havardh/bitless/README.md

TDT4295
=======

Datamaskinprosjektet 2013 - Energigruppa

NEWS:
* EBI is working!
* The SDcard is working!!!
* We have sound!
* Working on report structure! Using this: http://www.idi.ntnu.no/emner/tdt4260/_media/arch-paper-howto-2013.pdf
