havardh/bitless/docs/README.md

Documents
=========

A list of links to external documents used throughout the design process.

Xilinx Documents
----------------

* <a href="http://www.xilinx.com/support/documentation/sw_manuals/xilinx12_4/spartan6_hdl.pdf">Spartan-6 Libraries Guide for HDL Designs</a>
* <a href="http://www.xilinx.com/support/documentation/user_guides/ug382.pdf">Spartan-6 FPGA Clocking Resources</a>
* <a href="http://www.xilinx.com/support/documentation/user_guides/ug389.pdf">Spartan-6 FPGA DSP48A1 Slice</a>

ARM Documents
-------------

* <a href="http://infocenter.arm.com/help/topic/com.arm.doc.ddi0403c/index.html">ARMv7-M ARM Architecture Reference Manual</a> (for Cortex-M3 and -M4)
* <a href="http://infocenter.arm.com/help/index.jsp?topic=/com.arm.doc.ddi0419c/index.html">ARMv6-M ARM Architecture Reference Manual</a> (for Cortex-M0 and -M1)
* <a href="http://infocenter.arm.com/help/topic/com.arm.doc.set.cortexm/index.html">ARM Cortex-M Series Processor Documentation</a>

Energy Micro Documents
----------------------

* <a href="http://cdn.energymicro.com/dl/an/pdf/an0034_efm32_ebi.pdf">EFM32 External Bus Interface</a>
* <a href="http://cdn.energymicro.com/dl/an/pdf/an0030_efm32_fat_on_sd_card.pdf">EFM32 Fat on SD Card</a>
* <a href="http://cdn.energymicro.com/dl/an/pdf/an0002_efm32_hardware_design_considerations.pdf">EFM32 Hardware Design Considerations</a>
* <a href="http://cdn.energymicro.com/dl/devices/pdf/d0053_efm32gg_reference_manual.pdf">EFM32GG Reference Manual</a>

Various components
------------------
* <a href="http://www.farnell.com/datasheets/1647396.pdf">FT232RL - USB-USART Bridge</a>
