havardh/bitless/report/title.tex

% !TEX root = ./report.tex
\begin{titlepage}

\begin{center}

{\huge Bitless}\\[0.5cm]

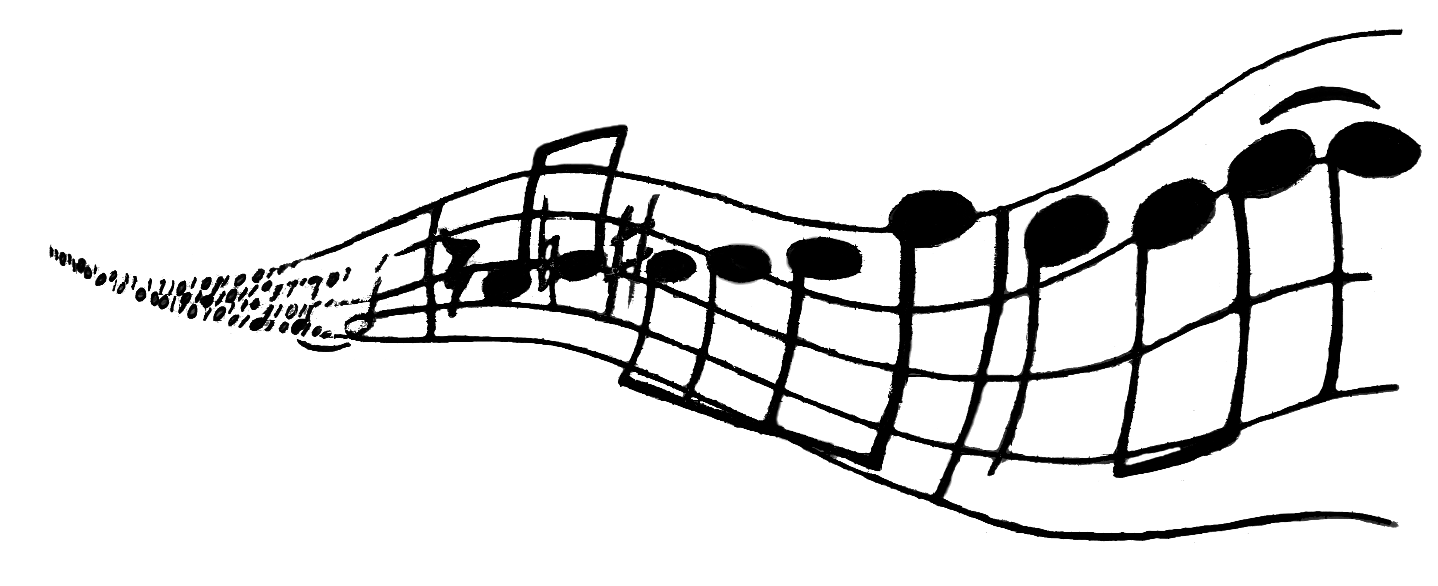
[picture p1: report/figures/logo.png]
    \\[2.5cm]

\textsc{\LARGE TDT4295 - computer design project}\\[2cm]

%\hrule{\linewidth}{0.35mm} %doesn't work

\begin{table}[h]
\centering
\begin{tabular}{rl}
    \textsc{Kristian Klomsten Skordal}  & \textsc{Jakob Dagsland Knutsen} \\
    \textsc{Hanna Holler Kamperud}      & \textsc{Håvard Wormdal Høiby} \\
    \textsc{Runar Bergheim Olsen}       & \textsc{Magnus Halvorsen}	\\
    \textsc{Olav Emil Eiksund}          & \textsc{Christian Chavez} \\
    \textsc{Sondre Lefsaker}            & \textsc{Terje Runde}
\end{tabular}
\end{table}

\vfill
\large{\today}

\end{center}

\end{titlepage}
