havardh/bitless/report/chapters/appendices.tex

% !TEX root = ../report.tex

\appendix
\begin{appendix}

\input{chapters/appendices/full-isa}
\input{chapters/appendices/fourier-transform}
\input{chapters/appendices/schematics}

\end{appendix}
