havardh/bitless/report/chapters/implementation.tex

% !TEX root = ../report.tex

\chapter{Implementation}\label{chapter:implementation}

This chapter describes implementation details of the system, and discusses decisions from the design process. It gives an overview of the \textit{ChaosM} implementation on the FPGA, how the MCU handles I/O and dataflow, and the PCB design. \clearpage

\clearpage
\input{chapters/implementation/system_overview}
\clearpage
\input{chapters/implementation/theory}
\clearpage
\input{chapters/implementation/fpga}
\clearpage
\input{chapters/implementation/mcu}
\clearpage
\input{chapters/implementation/pcb}
