havardh/bitless/report/chapters/methodology.tex

% !TEX root = ../report.tex

\chapter{Testing}\label{chapter:methodology}

This chapter details all the testing and their methodologies, as well as any
fixes implemented on the system.

\clearpage
\input{chapters/methodology/fpga-simulation}
\clearpage
\input{chapters/methodology/mcu-testing}
\clearpage
\input{chapters/methodology/pcb-testing}

% unit tests (cpputest)
% test programs (demos)
