havardh/bitless/report/figures/sw/fpga.tex

\begin{figure}[H]
    \centering
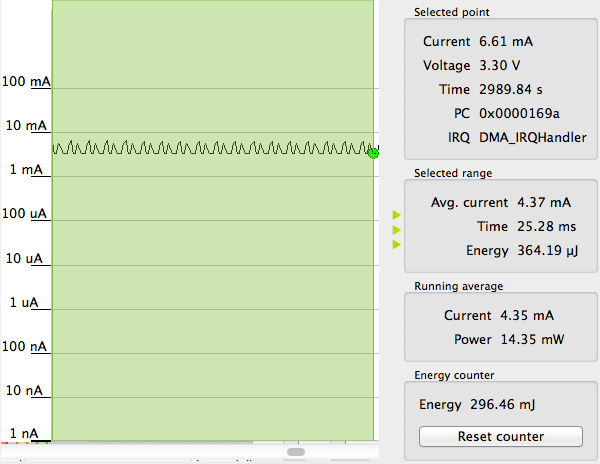
[picture p2: report/figures/sw/fpga.png]
    
    \caption{The energy usage during DMA}
    \label{fig:fpga}
\end{figure}
