havardh/bitless/report/chapters/appendices/fpga-core.tex

\begin{figure}[H]
	\centering
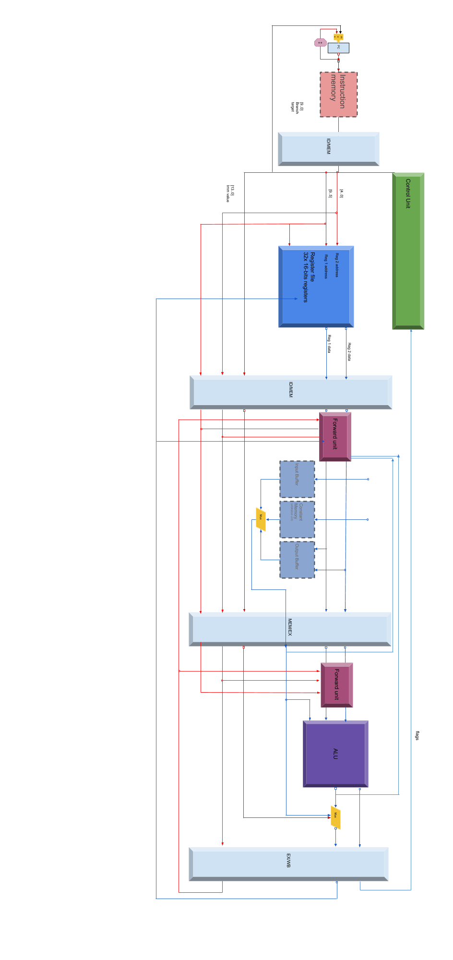
[picture p3: report/figures/fpga/core_schematic.png]
	
	\caption{A simplified schematic of the processor core design.}
	\label{fig:core_schematic}
\end{figure}
