havardh/bitless/report/chapters/appendices/schematics.tex

% !TEX root = ../../report.tex

\chapter{Schematics}\label{apx:schematics}

\section{ChaosM Schematics}
\clearpage
\input{chapters/appendices/fpga-core}

\section{PCB Schematics}
\includepdf[pages=-]{../pcb/take1/take1.pdf}
