havardh/bitless/report/figures/sw/sample-flow.tex

% !TEX root = ../../report.tex

\begin{figure}[H]
	\centering
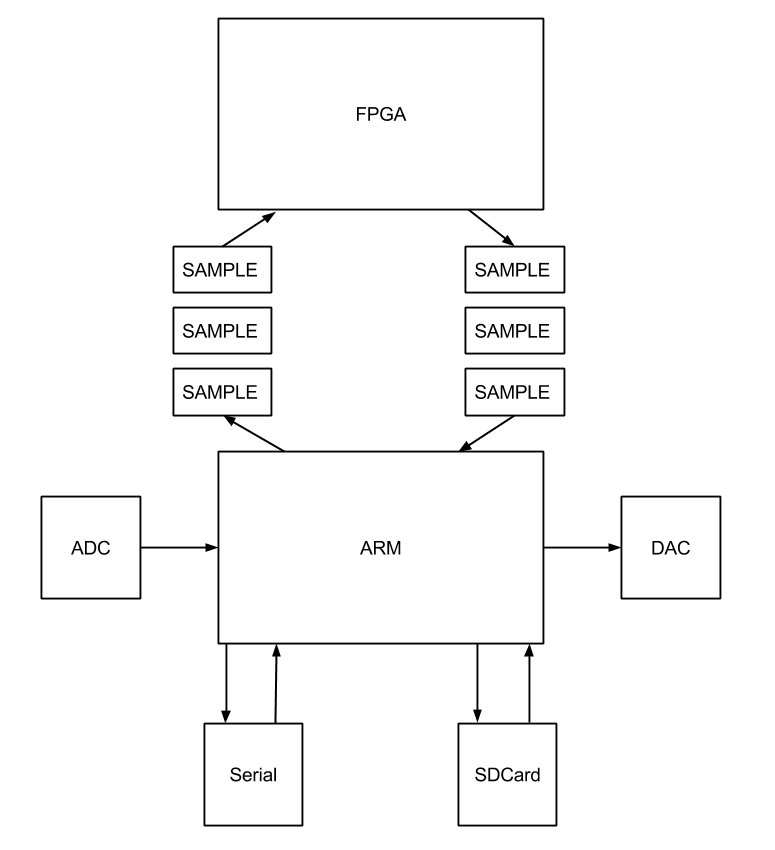
[picture p6: report/figures/sw/sample-flow.png]
	
	%\begin{tikzpicture}[shorten >= 1pt, node distance=3cm, on grid, auto]
	%	\node[draw,rectangle,minimum size=2cm] (fpga) {FPGA};
	%	\node[draw,rectangle,below of=fpga,minimum size=2cm] (arm) {ARM};
	%\end{tikzpicture}
	\caption{Flow of samples}
	\label{fig:sw_sample_flow}
\end{figure}
