havardh/bitless/report/figures/fpga/communication-ebi-addresses.tex

\begin{figure}[H]
	\centering
	\begin{bytefield}[endianness=big,bitwidth=0.04\linewidth]{23}
		\bitheader{0-22}\\
		\bitbox{1}{T} &
		\bitbox{2}{\tiny Pipeline} &
		\bitbox{4}{Device} &
		\bitbox{2}{\tiny Subdev} &
		\bitbox{14}{Address}
	\end{bytefield}
	\caption{FPGA address format}
	\label{fig:ebi_addresses}
\end{figure}
