havardh/bitless/report/figures/intro/pcb/bitless_overview.tex

\begin{figure}[H]
    \centering
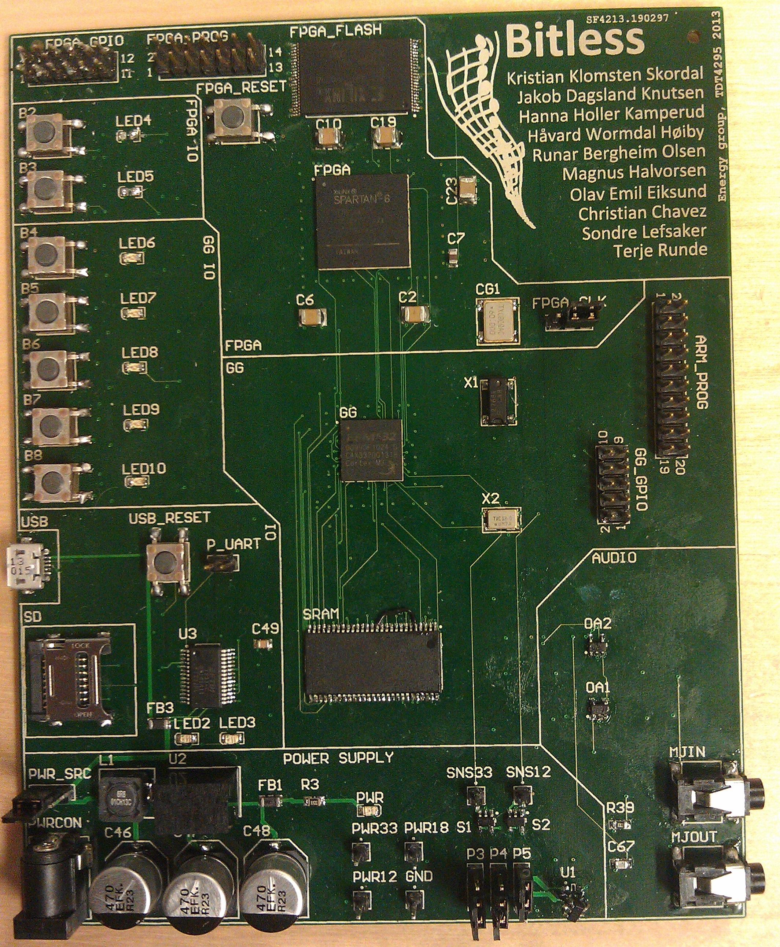
[picture p10: report/figures/intro/pcb/bitless_overview.jpg]
    
    \caption{The Bitless computer}
    \label{fig:bitless_overview}
\end{figure}
