havardh/bitless/report/figures/intro/pcb/bitless_psu.tex

\begin{figure}[H]
    \centering
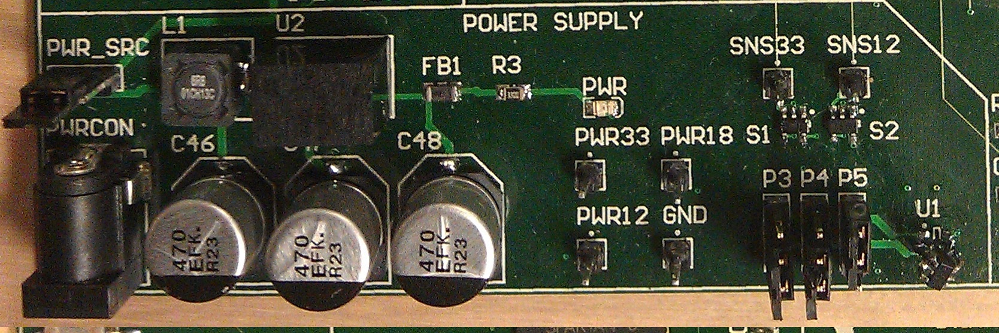
[picture p11: report/figures/intro/pcb/bitless_psu.jpg]
    
    \caption{The power supply}
    \label{fig:psu}
\end{figure}
