havardh/bitless/report/chapters/implementation/pcb/layout.tex

\subsection{Layout}

Drawing connections between components on a PCB can be a complicated process,
and is crucial to a successful PCB design. Following is how the PCB layout
of this project's system was implemented.

\input{chapters/implementation/pcb/layout/routing}
\input{chapters/implementation/pcb/layout/layer_stack}
\input{chapters/implementation/pcb/layout/footprints}
