havardh/bitless/report/chapters/implementation/pcb/ee_design.tex

% !TEX root = ../../../report.tex

\subsection{Designing for energy efficiency}

The PCB
