havardh/bitless/report/chapters/implementation/mcu/modes.tex

\subsection{Modes}

As described in the introduction the system has multiple input and output
sources for the samples flowing through the system. The modes consists of the
different combinations of sources and are as follows:

\begin{enumerate}
\item ADC to DAC - Like an effect pedal
\item ADC to SDCard - Like a taperecorder
\item SDCard to DAC - Like a wavplayer
\item SDCard to SDCard - Like a
	%\caption{Dataflow modes}
	\label{enum:data_flow_modes}
\end{enumerate}
