havardh/bitless/report/chapters/implementation/pcb/layout/footprints.tex

% !TEX root = ../../../../report.tex
\subsubsection{Footprints}

Each component is associated with a schematic drawing and a footprint. Because certain components were not available in public libraries they had to be drawn from scratch. Below is a list of all custom component drawings.

\begin{table}[H]
	\centering
	\begin{tabular}{| l | c | c |}
		\hline
		\textbf{Component} & \textbf{Footprint}  & \textbf{Schematic} \\
		\hline
		XP Power Switch-Mode Regulator & X & X \\
		Würth Electronics MicroSD & X & X \\
		Molex MicroUSB AB & X & X \\
		Lumberg 3.5mm audio jack & X & X \\
		Buttons & X & X \\
		DC-10B & X & X \\
		\hline
		Texas Instruments Op amp & - & X \\
		Diodes INC. Linear regulator& - & X \\
		Diodes INC. Current Monitor & - & X \\
		Cypress Semiconductor SRAM & - & X \\
		TXC-7B crystal & - & X \\
		TXC-7W crystal & - & X \\
		\hline
	\end{tabular}
	\caption{Custom footprints and schematics}
	\label{tab:footprints}
\end{table}
