havardh/bitless/report/chapters/implementation/pcb/layout/routing.tex

% !TEX root = ../../../../report.tex

\subsubsection{Routing}

Almost everything was autorouted, with a few exceptions. The power supply had to be done manually, as well as the fanout on the FPGA. The routes are visible in the last image of Appendix~\ref{apx:schematics}.
