havardh/bitless/report/acks.tex

\section*{Acknowledgments}
We would like to thank the following people for their help and input during the
project:

\begin{description}
  \item[Gunnar Tufte] for coordinating the project, and being himself
  \item[Yaman Umuroglu] for always being available for questions
  \item[Odd Rune S. Lykkebø] for providing technical support on every level
  \item[Stefano Nichele] for helping out with our orders
  \item[Stian Hvatum] for excellent support during PCB development
  \item[Team Barricelli] for timesharing the labs
\end{description}
\newpage
