havardh/bitless/report/report.tex

\documentclass[fontsize=11pt,paper=a4,titlepage,openany]{report}

\input{config} % Insert style

\begin{document}

\input{./title}
\input{./acks}
\input{./abstract}

\tableofcontents
\newpage
\listoffigures
\listoftables
%\lstlistoflistings

\input{chapters/intro}
\input{chapters/implementation}
\input{chapters/methodology}
\input{chapters/results}
\input{chapters/conclusion}

\bibliography{bibliography}{}
\bibliographystyle{plain}

\input{chapters/appendices}

\end{document}
