havardh/bitless/report/figures/sw/preamp.tex

\begin{figure}[H]
    \centering
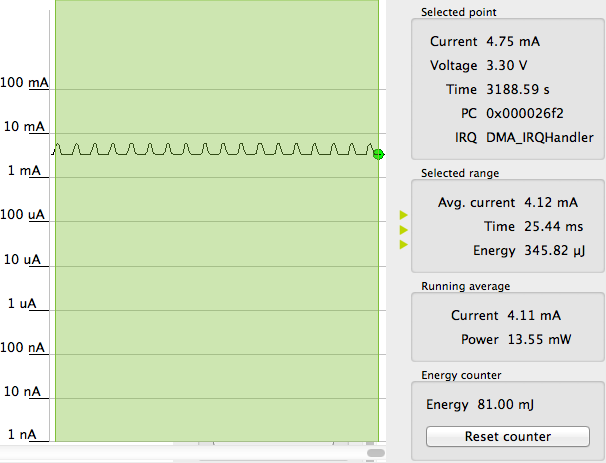
[picture p12: report/figures/sw/preamp.png]
    
    \caption{Energy usage for demo code}
    \label{fig:preamp}
\end{figure}
