havardh/bitless/report/figures/sw/software-stack.tex

\begin{figure}[H]
    \centering
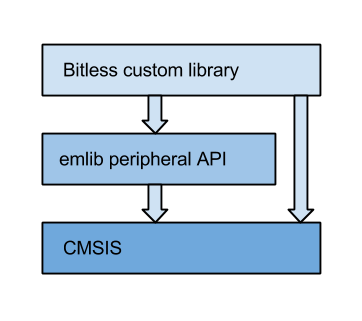
[picture p15: report/figures/sw/software-stack.png]
    
    \caption{The software stack used on the microcontroller}
    \label{fig:software-stack}
\end{figure}
