havardh/bitless/report/figures/sw/transfer-phases.tex

\begin{figure}[H]
	\centerline{
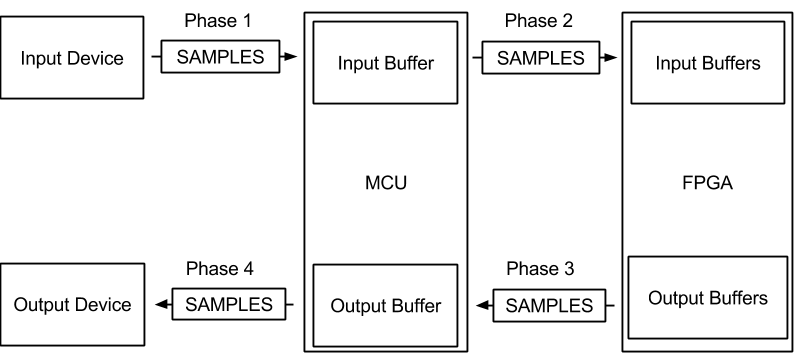
[picture p16: report/figures/sw/transfer-phases.png]
	}
	\caption{Transfer phases}
	\label{fig:sw_transfer_phases}
\end{figure}
\FloatBarrier
