havardh/bitless/report/figures/intro/nonfunctional-reqs.tex

\begin{table}[H]
\centering
    \begin{tabular}{| l | p{8cm} |}
    \hline
    \textbf{Name} & \textbf{Requirement}\\
    \hline \hline
    \textbf{NFR1} & The project should have a cool name and logo. \\
    \textbf{NFR4} & The FPGA must be a Xilinx Spartan 6 \\
    \textbf{NFR5} & The microcontroller should be an EFM32GG990F1024 \\
    \textbf{NFR6} & The final system should be optimized for low energy consumption \\
    \textbf{NFR7} & The budget of 10.000 NOK should cover all production 
    and component expenses. \\

    \hline
    \end{tabular}
    \caption{The non-functional requirements}
    \label{tab:nonfunref}
\end{table}
