havardh/bitless/report/figures/fpga/communication-ebi-read.tex

\begin{figure}[h]
	\centering
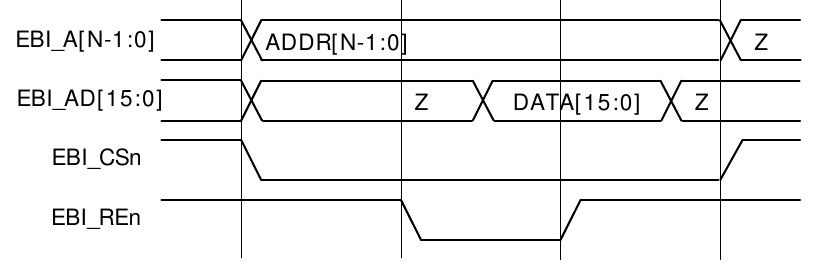
[picture p17: report/figures/fpga/ebi_read.png]
	
	\caption{EBI read transfer\cite[p.7]{efm_ebi}}
	\label{fig:ebi_read}
\end{figure}
