havardh/bitless/report/figures/fpga/communication-ebi-write.tex

\begin{figure}[h]
	\centering
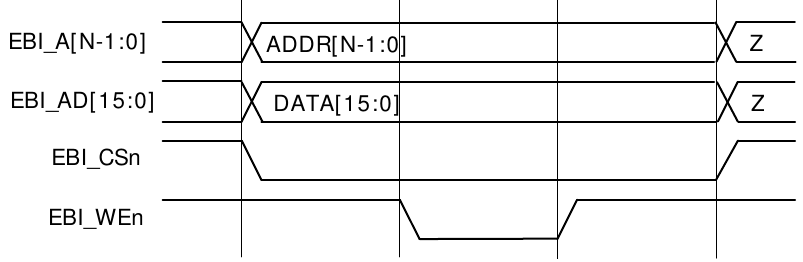
[picture p18: report/figures/fpga/ebi_write.png]
	
	\caption{EBI write transfer\cite[p.6]{efm_ebi}}
	\label{fig:ebi_write}
\end{figure}
