havardh/bitless/report/chapters/pcb/components/usb_uart.tex

% !TEX root = ../../report.tex

\subsection{USB-UART}

{\bf USB-UART}
\begin{itemize} \item FTDI FT232RL - USB-UART converter \item 1x 4k7 and 1x 10k
\item 3x 100nF and 1x 4.7uF \item USB3140-30-0170-1-C USB Micro B connector
\end{itemize}
