havardh/bitless/report/figures/fpga/isa-regbased-instructions.tex

\begin{table}[H]
	\centering
	\begin{tabular}{|l l l l l|}
		\hline
		\textbf{Funct} & \textbf{Opt}  & \textbf{Mnemonic} & \textbf{Instruction} & \textbf{Operation} \\
	\hline
	\multicolumn{5}{|c|}{Group \texttt{0b00}} \\
	\hline
	\multirow{3}{*}{\texttt{0b00}}
		& \texttt{0b00} & \texttt{add \$ra, \$rb}  & Add registers & $\$ra \leftarrow \$ra + \$rb$ \\
		& \texttt{0b01} & \texttt{addi \$ra, imm} & Add immediate & $\$ra \leftarrow \$ra + imm$ \\
		& \texttt{0b10} & \texttt{fadd \$ra, \$rb} & Add registers (FP) & $\$ra \leftarrow \$ra + \$rb$ \\
	\multirow{4}{*}{\texttt{0b01}}
		& \texttt{0b00} & \texttt{sub \$ra, \$rb}  & Subtract registers & $\$ra \leftarrow \$ra - \$rb$ \\
		& \texttt{0b01} & \texttt{fsub \$ra, \$rb} & Subtract registers (FP) & $\$ra \leftarrow \$ra - \$rb$ \\
		& \texttt{0b10} & \texttt{cmp \$ra, \$rb}  & Compare & $cnd \leftarrow cnd(\$ra - \$rb)$ \\
		& \texttt{0b11} & - & compare fp / subtract imm? & - \\
	\multirow{4}{*}{\texttt{0b10}}
		& \texttt{0b00} & \texttt{mul \$ra, \$rb}  & Multiply registers & $\$ra \leftarrow \$ra * \$rb$ \\
		& \texttt{0b01} & \texttt{fmul \$ra, \$rb} & Multiply registers (FP) & $\$ra \leftarrow \$ra * \$rb$ \\
		& \texttt{0b10} & \texttt{fmla \$ra, \$rb} & Multiply-and-accumulate (FP) & $\$ra \leftarrow \$ra + \$rb * \$rc$ \\
		& \texttt{0b11} & \texttt{fmls \$ra, \$rb} & Multiply-and-subtract (FP) & $\$ra \leftarrow \$ra - \$rb * \$rc$ \\
	\multirow{4}{*}{\texttt{0b11}}
		& \texttt{0b0x} & \texttt{halt} & Stop processor &  \\
		& \texttt{0b10} & \texttt{fmla \$ra, \$rb} & Multiply-and-accumulate (FP) & $\$ra \leftarrow \$ra + \$rb * \$rd$ \\
		& \texttt{0b11} & \texttt{fmls \$ra, \$rb} & Multiply-and-subtract (FP) & $\$ra \leftarrow \$ra - \$rb * \$rd$ \\
	\hline
	\multicolumn{5}{|c|}{Group \texttt{0b01}} \\
	\hline
	\multirow{2}{*}{\texttt{0b00}}
		& \texttt{0b00} & \texttt{and \$ra, \$rb} & And & $\$ra \leftarrow \$ra \wedge \$rb$ \\
		& \texttt{0b01} & \texttt{nand \$ra, \$rb} & Nand & $\$ra \leftarrow \neg(\$ra \wedge \$rb)$ \\
	\multirow{3}{*}{\texttt{0b01}}
		& \texttt{0b00} & \texttt{or \$ra, \$rb} & Or & $\$ra \leftarrow \$ra \vee \$rb$ \\
		& \texttt{0b01} & \texttt{nor \$ra, \$rb} & Nor & $\$ra \leftarrow \neg(\$ra \vee \$rb)$\\
		& \texttt{0b10} & \texttt{xor \$ra, \$rb} & Xor & $\$ra \leftarrow \$ra \oplus \$rb$\\
	\multirow{4}{*}{\texttt{0b10}}
		& \texttt{0b00} & \texttt{mov \$ra, \$rb} & Move & $\$ra \leftarrow \$rb$\\
		& \texttt{0b01} & \texttt{mvn \$ra, \$rb} & Move negative & $\$ra \leftarrow \neg\$rb$ \\
		& \texttt{0b10} & \texttt{i2f \$ra, \$rb} & Typecast (Int to FP) & $\$ra \leftarrow fp(\$rb)$ \\
		& \texttt{0b11} & \texttt{f2i \$ra, \$rb} & Typecast (Fp to int) & $\$ra \leftarrow int(\$rb)$ \\
	\multirow{4}{*}{\texttt{0b11}}
		& \texttt{0b00} & \texttt{lda \$ra, [\$rb]} & Load from input & $\$ra \leftarrow [\$rb]$ \\
		& \texttt{0b01} & \texttt{ldb \$ra, [\$rb]} & Load from output & $\$ra \leftarrow [\$rb]$ \\
		& \texttt{0b10} & \texttt{ldc \$ra, [\$rb]} & Load from constant buffer & $\$rd\ and\ \$rc \leftarrow [\$rb]$ \\
		& \texttt{0b11} & \texttt{stb \$ra, [\$rb]} & Store to output & $[\$rb] \leftarrow \$ra$ \\
	\hline
	\end{tabular}
	\caption{Register-based instruction list}
	\label{tab:regbased_instrs}
\end{table}
