havardh/bitless/report/figures/results/pcb/bus.tex

\begin{figure}[H]
    \centering
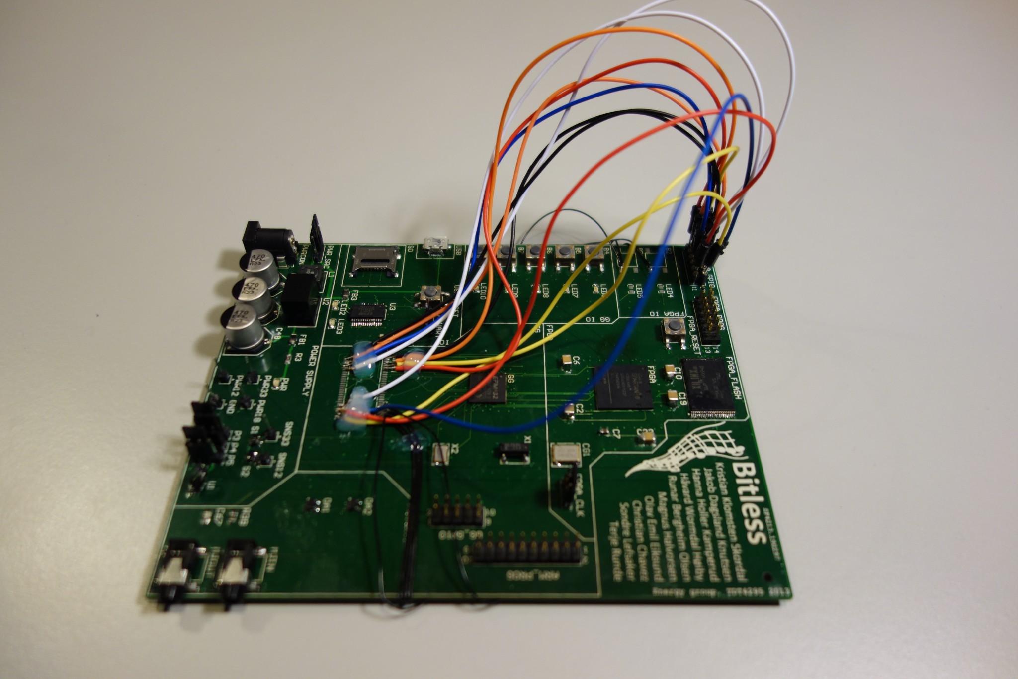
[picture p19: report/figures/results/pcb/bus.jpg]
    
    \caption{Bus hack.}
    \label{fig:res:bus}
\end{figure}
