havardh/bitless/report/figures/results/pcb/lfxtal.tex

\begin{figure}[H]
    \centering
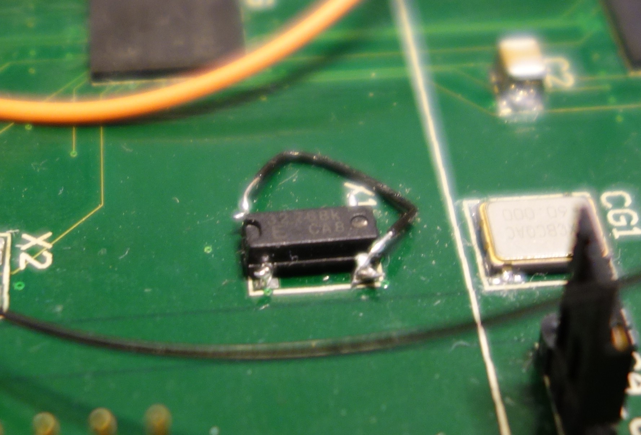
[picture p20: report/figures/results/pcb/lfxtal.jpg]
    
    \caption{Low frequency crystal hack.}
    \label{fig:res:lfxtal}
\end{figure}
