havardh/bitless/report/figures/results/pcb/linear-regulator.tex

\begin{figure}[H]
    \centering
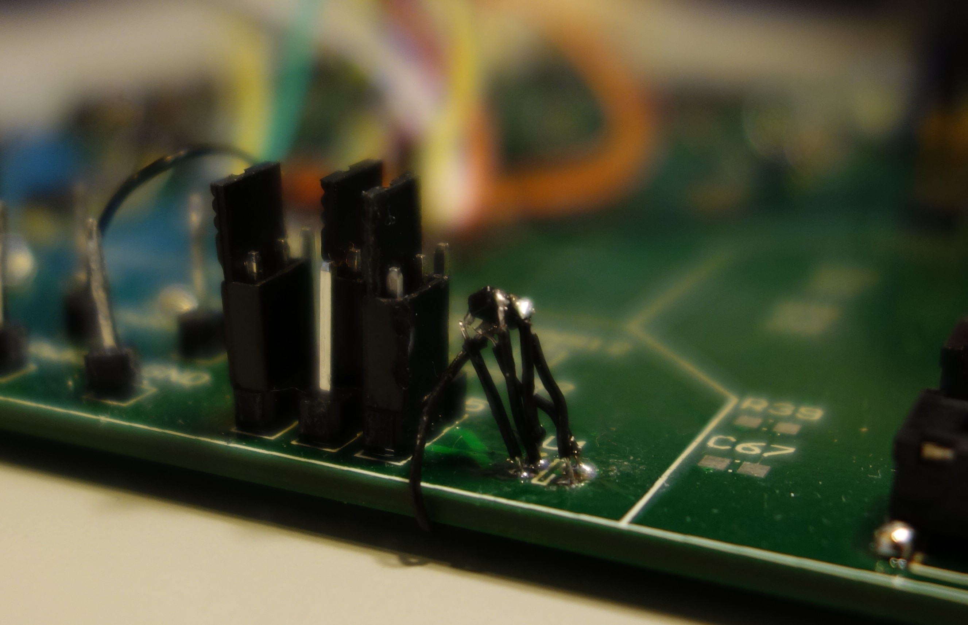
[picture p21: report/figures/results/pcb/linear-regulator.jpg]
    
    \caption{Linear voltage regulator hack.}
    \label{fig:res:linreg}
\end{figure}
