havardh/bitless/vhdl/pipeline/core/alu/generated cores/fix_to_float/fix_to_float_readme.txt

The following files were generated for 'fix_to_float' in directory 
Z:\TDT4295_3\ipcore_dir\

fix_to_float.asy:
   Graphical symbol information file. Used by the ISE tools and some
   third party tools to create a symbol representing the core.

fix_to_float.gise:
   ISE Project Navigator support file. This is a generated file and should
   not be edited directly.

fix_to_float.ngc:
   Binary Xilinx implementation netlist file containing the information
   required to implement the module in a Xilinx (R) FPGA.

fix_to_float.sym:
   Please see the core data sheet.

fix_to_float.v:
   Verilog wrapper file provided to support functional simulation.
   This file contains simulation model customization data that is
   passed to a parameterized simulation model for the core.

fix_to_float.veo:
   VEO template file containing code that can be used as a model for
   instantiating a CORE Generator module in a Verilog design.

fix_to_float.vhd:
   VHDL wrapper file provided to support functional simulation. This
   file contains simulation model customization data that is passed to
   a parameterized simulation model for the core.

fix_to_float.vho:
   VHO template file containing code that can be used as a model for
   instantiating a CORE Generator module in a VHDL design.

fix_to_float.xco:
   CORE Generator input file containing the parameters used to
   regenerate a core.

fix_to_float.xise:
   ISE Project Navigator support file. This is a generated file and should
   not be edited directly.

fix_to_float_readme.txt:
   Text file indicating the files generated and how they are used.

fix_to_float_xmdf.tcl:
   ISE Project Navigator interface file. ISE uses this file to determine
   how the files output by CORE Generator for the core can be integrated
   into your ISE project.

fix_to_float_flist.txt:
   Text file listing all of the output files produced when a customized
   core was generated in the CORE Generator.

Please see the Xilinx CORE Generator online help for further details on
generated files and how to use them.
