havardh/bitless/vhdl/pipeline/core/alu/generated cores/float_to_fix/float_to_fix_readme.txt

The following files were generated for 'float_to_fix' in directory 
Z:\TDT4295_3\ipcore_dir\

float_to_fix.asy:
   Graphical symbol information file. Used by the ISE tools and some
   third party tools to create a symbol representing the core.

float_to_fix.gise:
   ISE Project Navigator support file. This is a generated file and should
   not be edited directly.

float_to_fix.ngc:
   Binary Xilinx implementation netlist file containing the information
   required to implement the module in a Xilinx (R) FPGA.

float_to_fix.sym:
   Please see the core data sheet.

float_to_fix.v:
   Verilog wrapper file provided to support functional simulation.
   This file contains simulation model customization data that is
   passed to a parameterized simulation model for the core.

float_to_fix.veo:
   VEO template file containing code that can be used as a model for
   instantiating a CORE Generator module in a Verilog design.

float_to_fix.vhd:
   VHDL wrapper file provided to support functional simulation. This
   file contains simulation model customization data that is passed to
   a parameterized simulation model for the core.

float_to_fix.vho:
   VHO template file containing code that can be used as a model for
   instantiating a CORE Generator module in a VHDL design.

float_to_fix.xco:
   CORE Generator input file containing the parameters used to
   regenerate a core.

float_to_fix.xise:
   ISE Project Navigator support file. This is a generated file and should
   not be edited directly.

float_to_fix_readme.txt:
   Text file indicating the files generated and how they are used.

float_to_fix_xmdf.tcl:
   ISE Project Navigator interface file. ISE uses this file to determine
   how the files output by CORE Generator for the core can be integrated
   into your ISE project.

float_to_fix_flist.txt:
   Text file listing all of the output files produced when a customized
   core was generated in the CORE Generator.

Please see the Xilinx CORE Generator online help for further details on
generated files and how to use them.
