havardh/bitless/vhdl/pipeline/core/alu/generated cores/fix_to_float/fix_to_float_flist.txt

# Output products list for <fix_to_float>
_xmsgs\pn_parser.xmsgs
fix_to_float.asy
fix_to_float.gise
fix_to_float.ngc
fix_to_float.sym
fix_to_float.v
fix_to_float.veo
fix_to_float.vhd
fix_to_float.vho
fix_to_float.xco
fix_to_float.xise
fix_to_float_flist.txt
fix_to_float_readme.txt
fix_to_float_xmdf.tcl
