havardh/bitless/vhdl/pipeline/core/alu/generated cores/float_to_fix/float_to_fix_flist.txt

# Output products list for <float_to_fix>
_xmsgs\pn_parser.xmsgs
float_to_fix.asy
float_to_fix.gise
float_to_fix.ngc
float_to_fix.sym
float_to_fix.v
float_to_fix.veo
float_to_fix.vhd
float_to_fix.vho
float_to_fix.xco
float_to_fix.xise
float_to_fix_flist.txt
float_to_fix_readme.txt
float_to_fix_xmdf.tcl
