havardh/bitless/pcb/efm32_pinout/pinout.pdf

## EFM32GG990F1024, package BGA112 - Top view

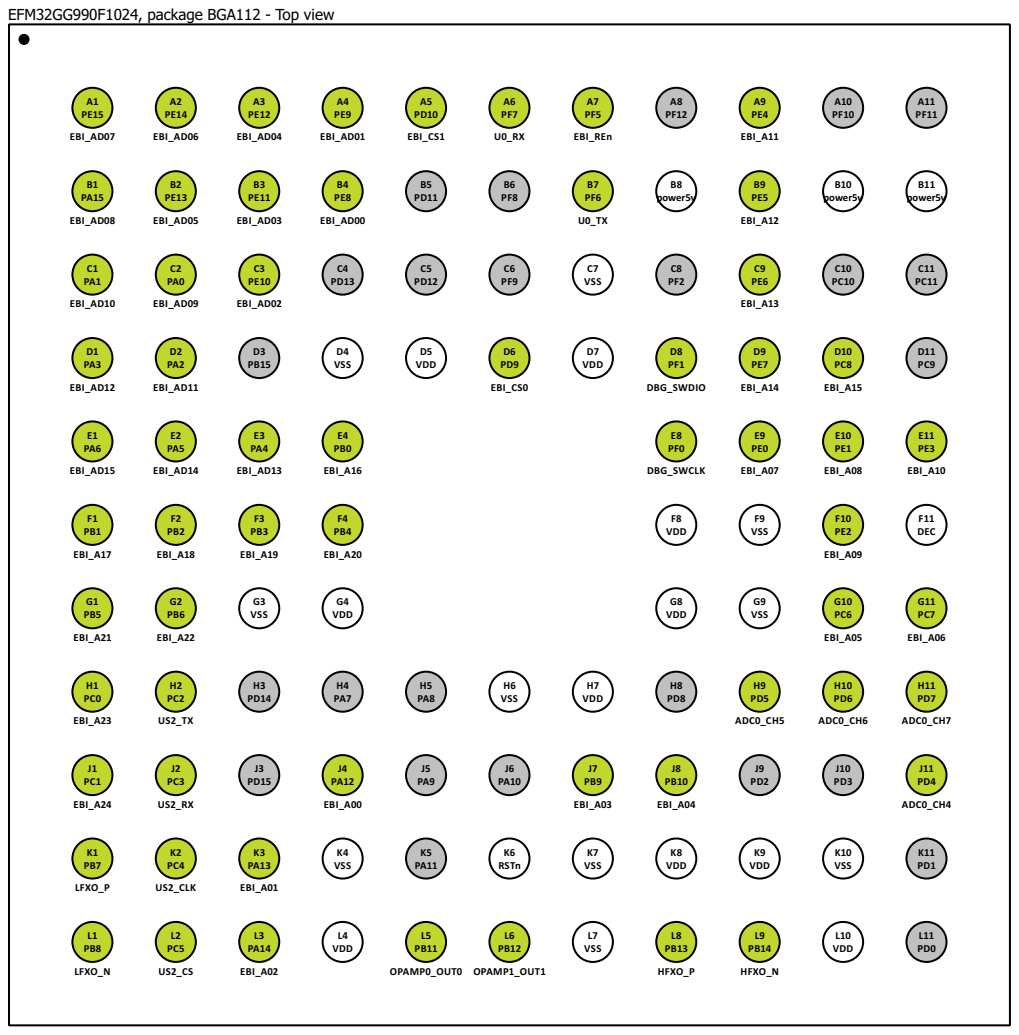
[picture p22: page 1]
