havardh/bitless/pcb/take1/take1.pdf

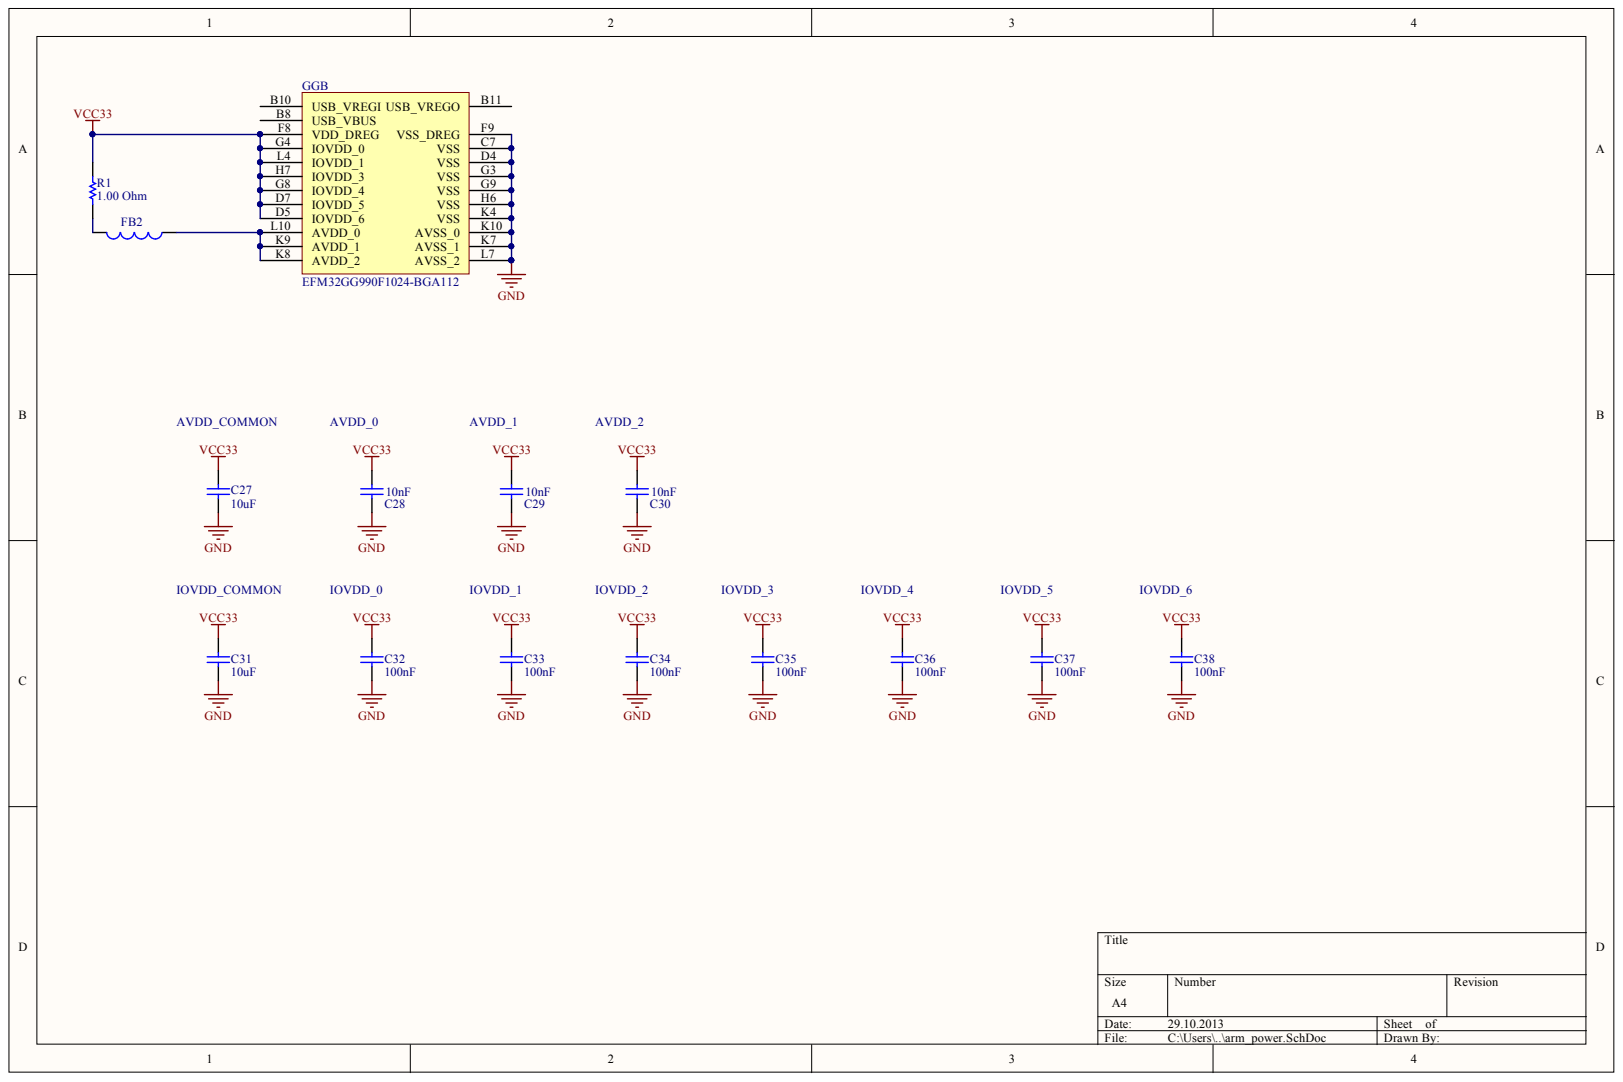
[picture p23: page 1]

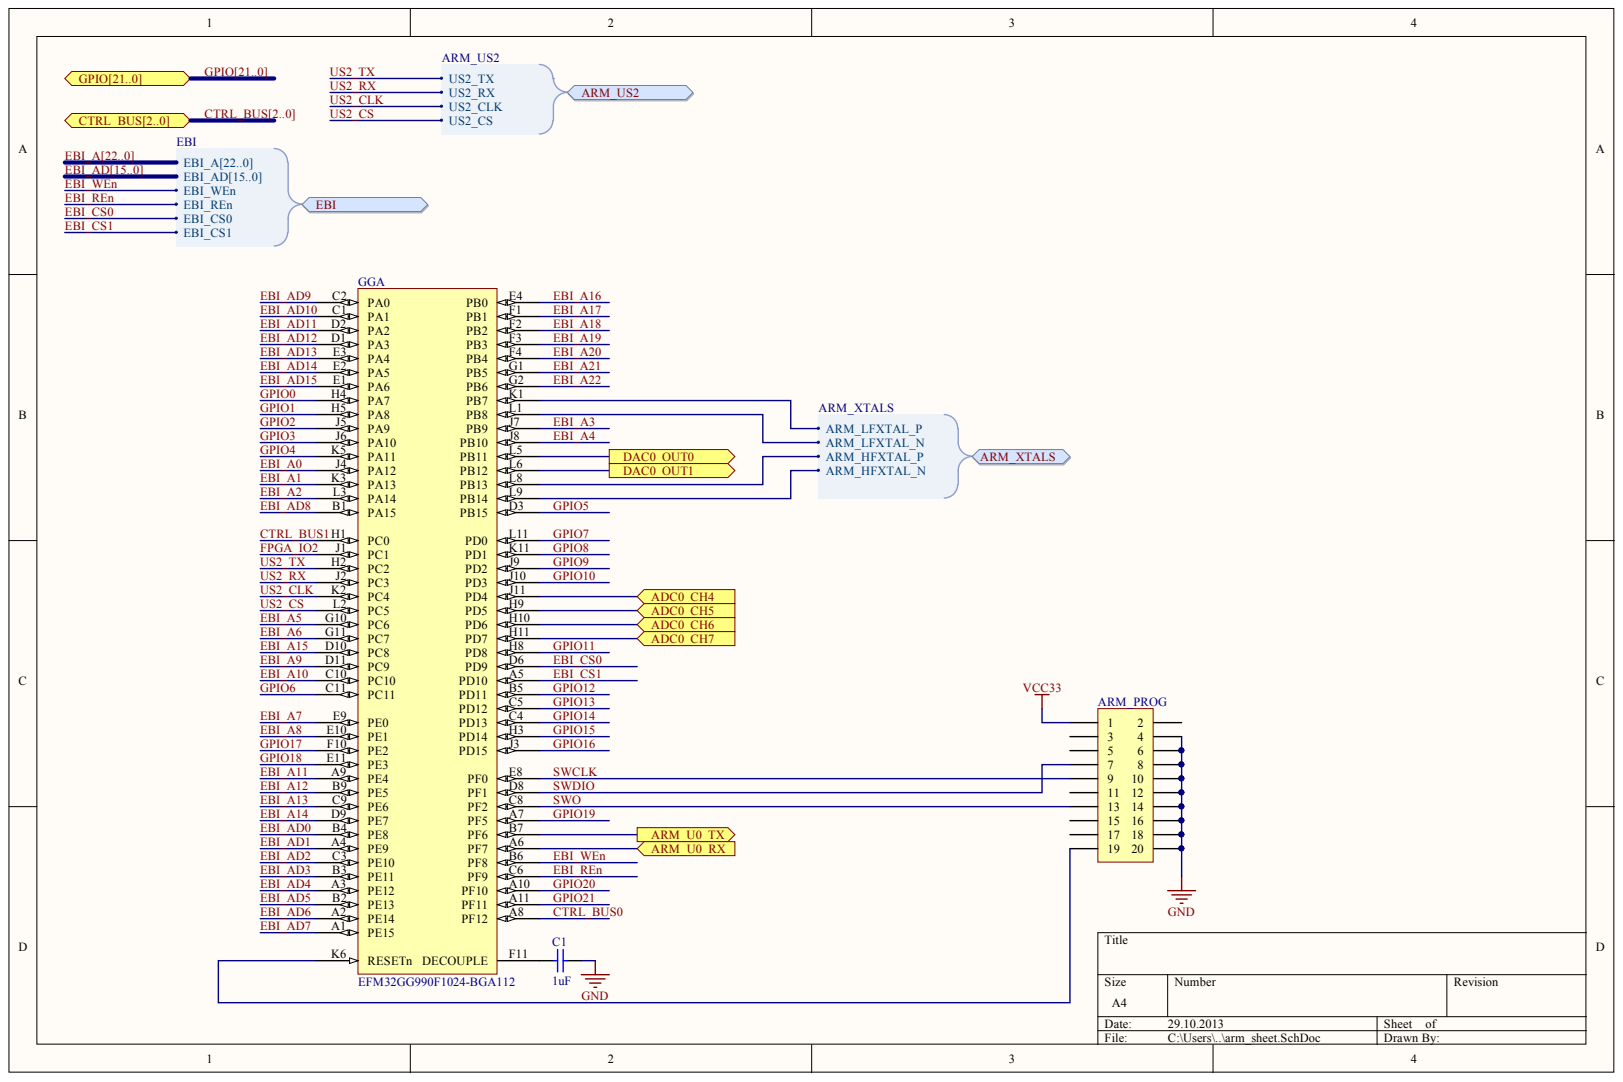
[picture p24: page 2]

EBI_A3
EBI_A4

SWCLK
SWDIO

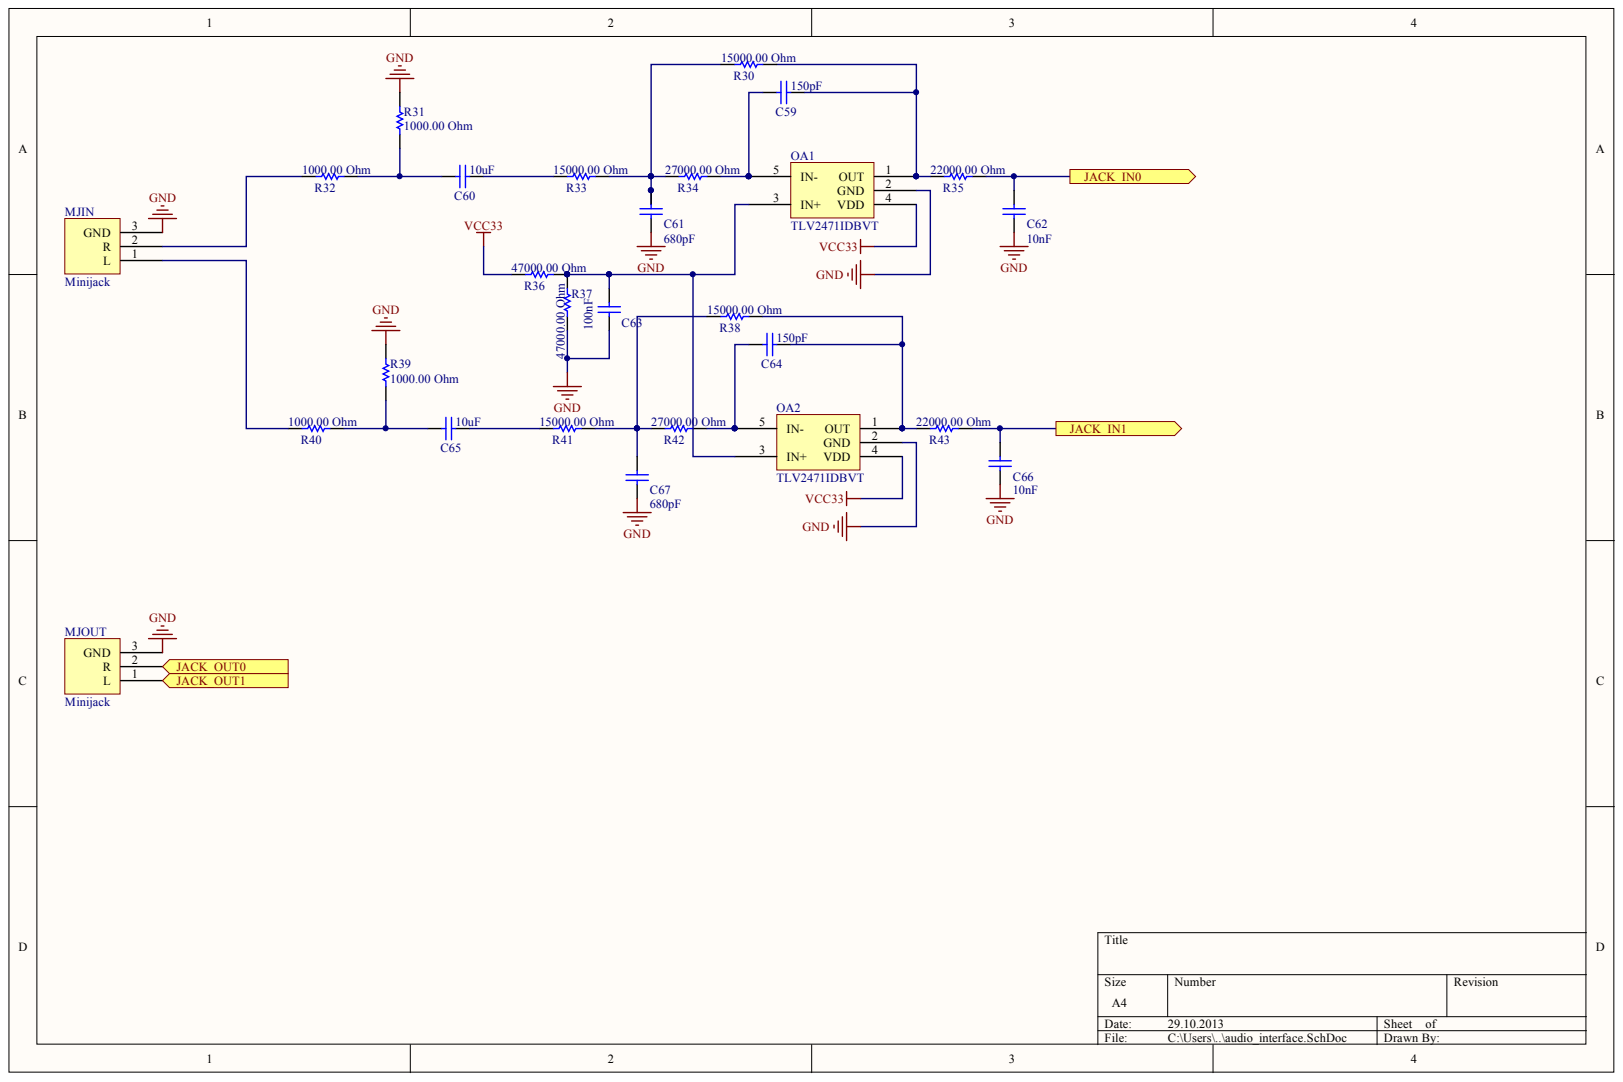
[picture p25: page 3]

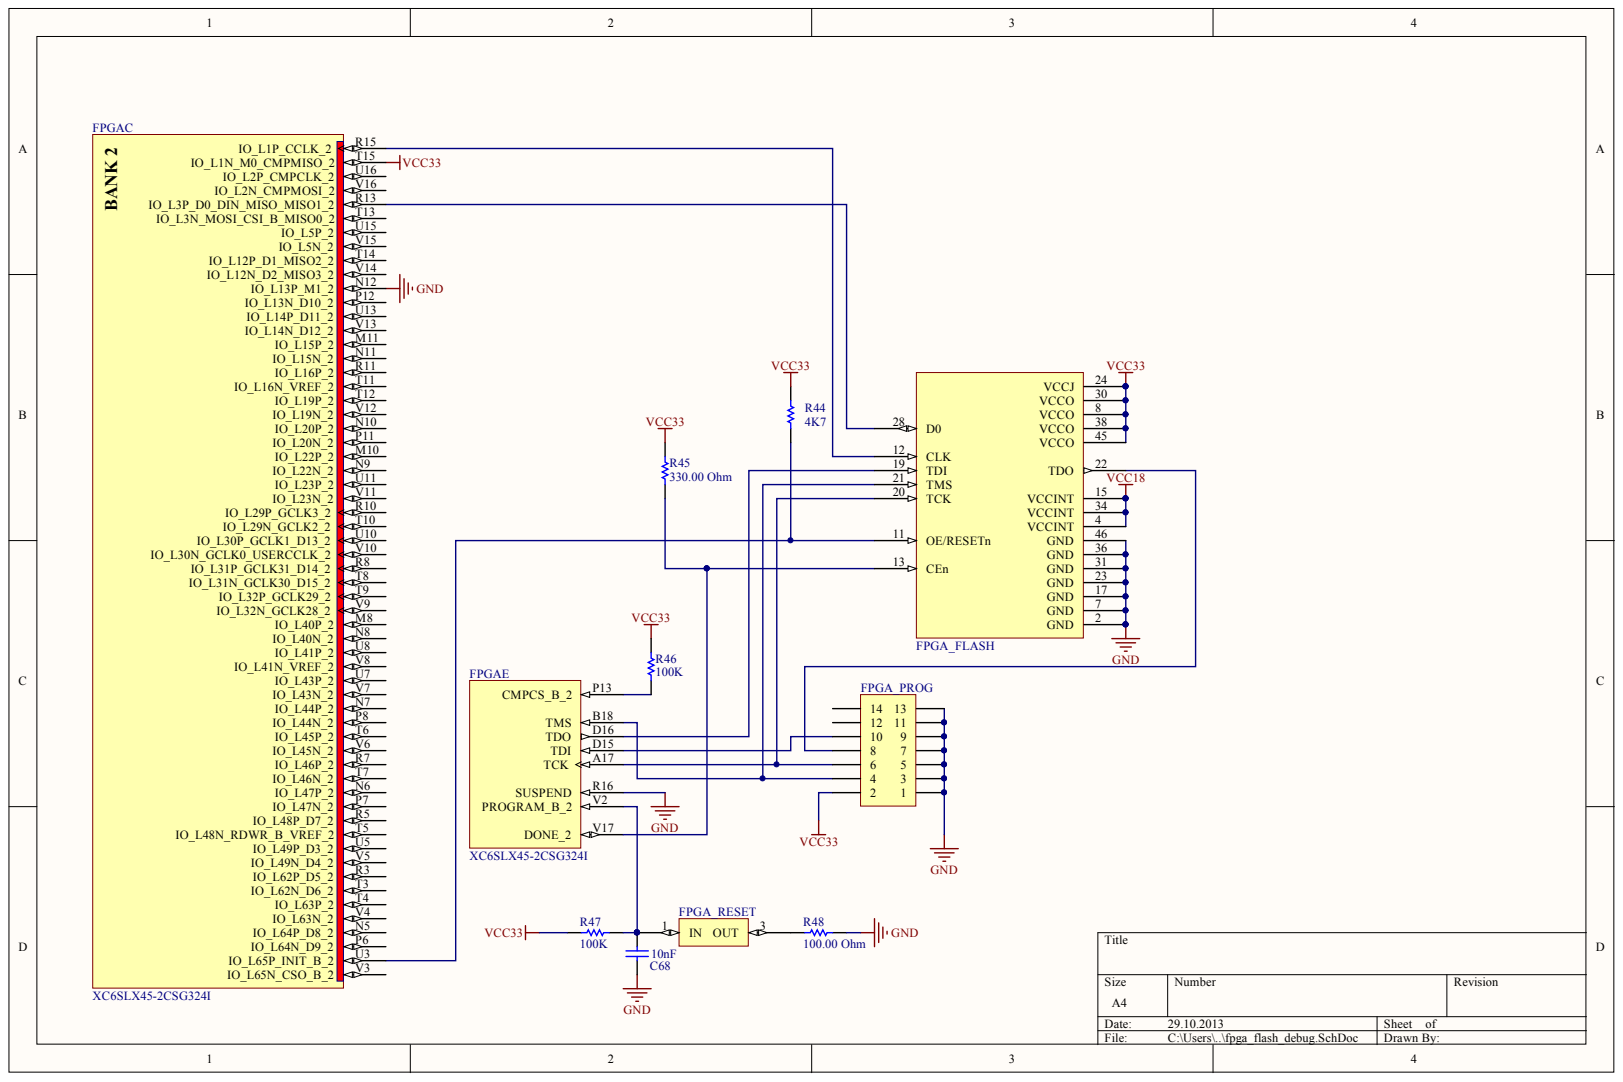
[picture p26: page 4]

VCC33 R44 VCC33 4K7

R45 | TDI 19

CLK 12

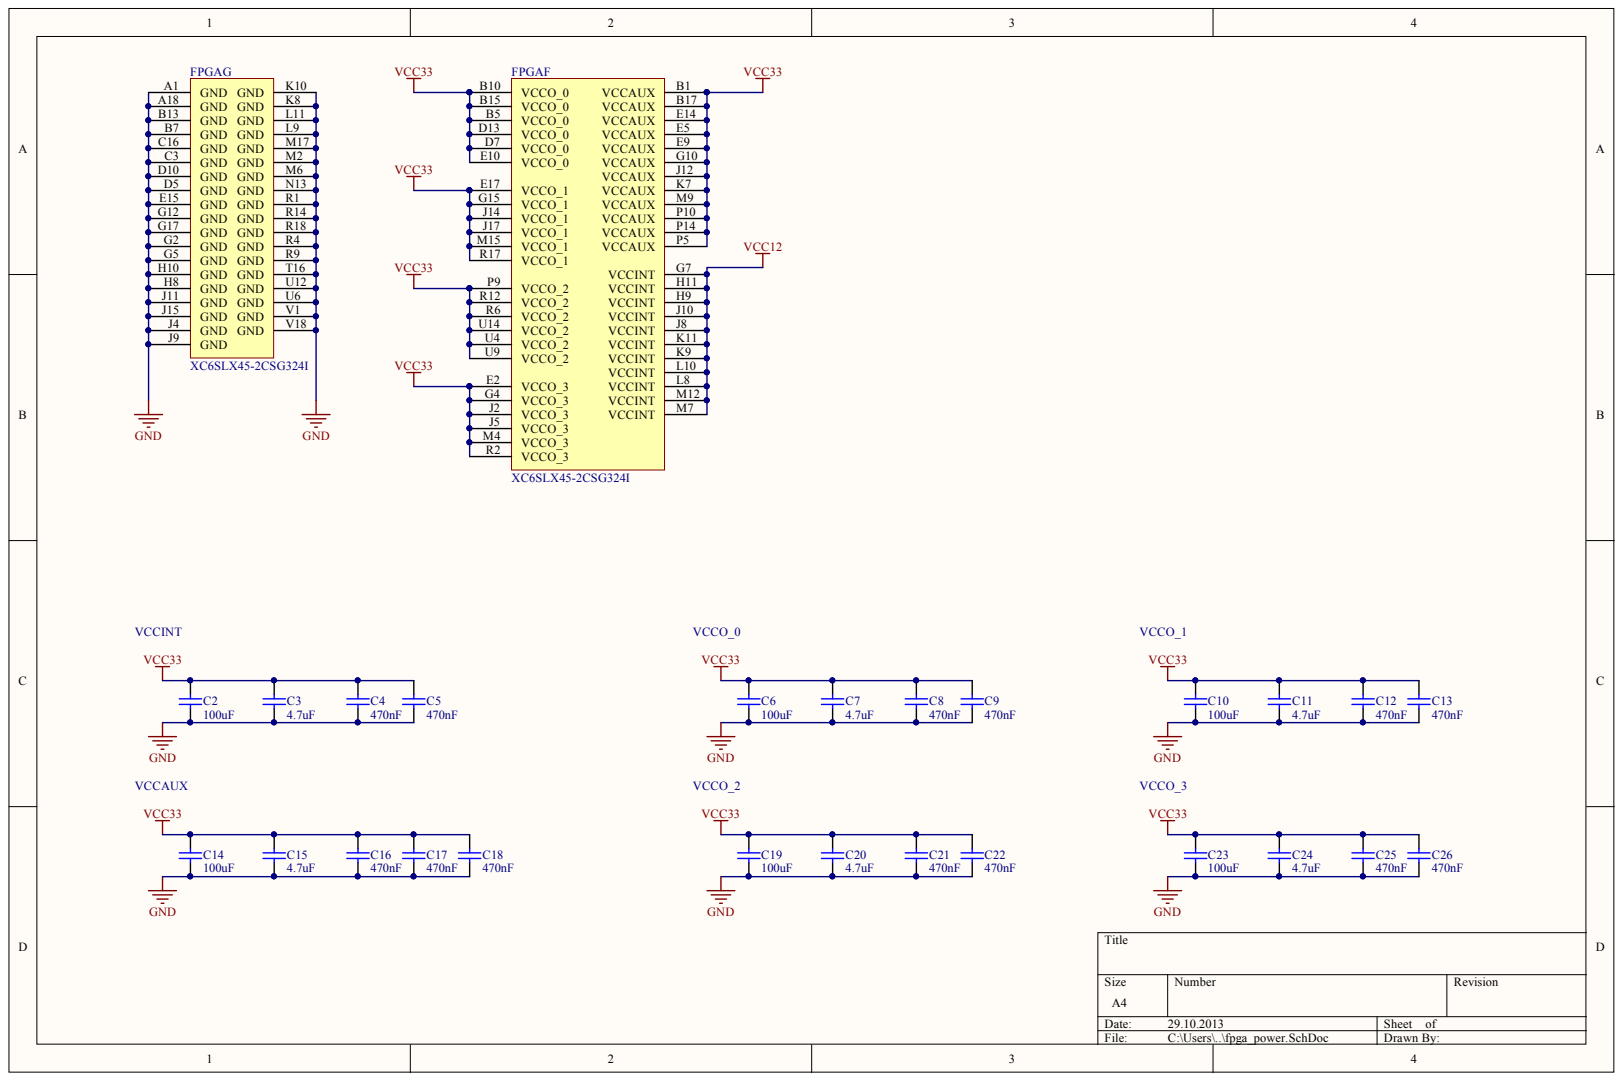
[picture p27: page 5]

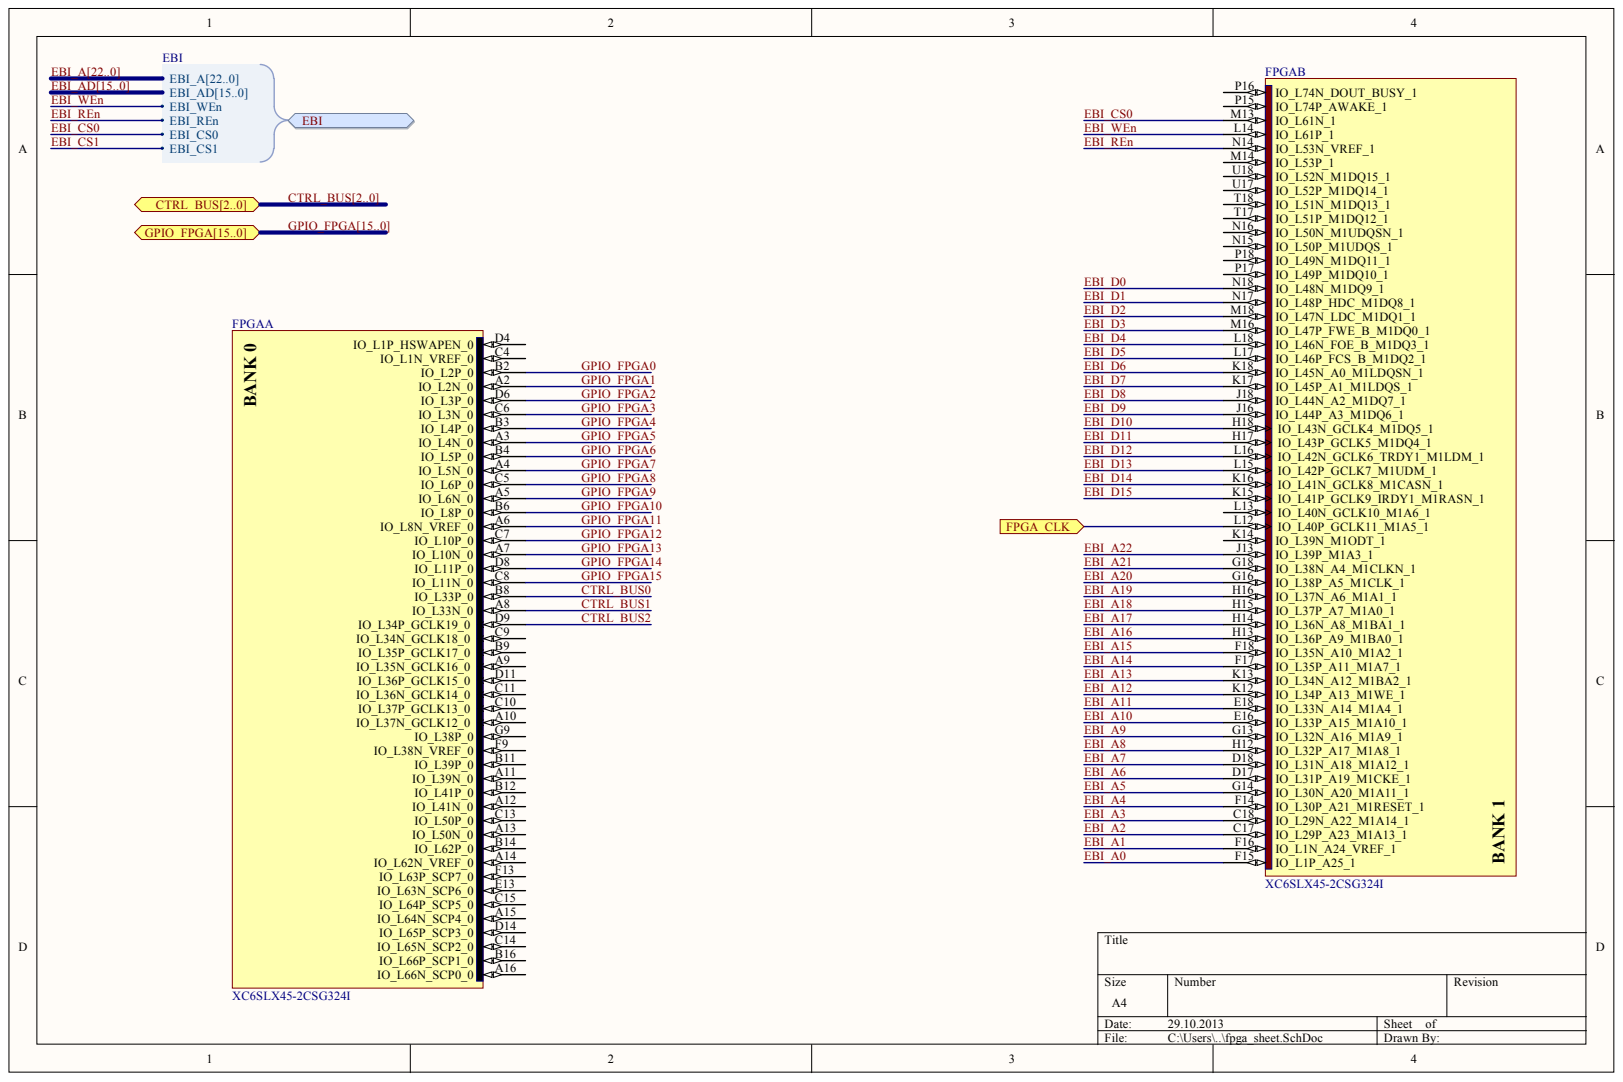
[picture p28: page 6]

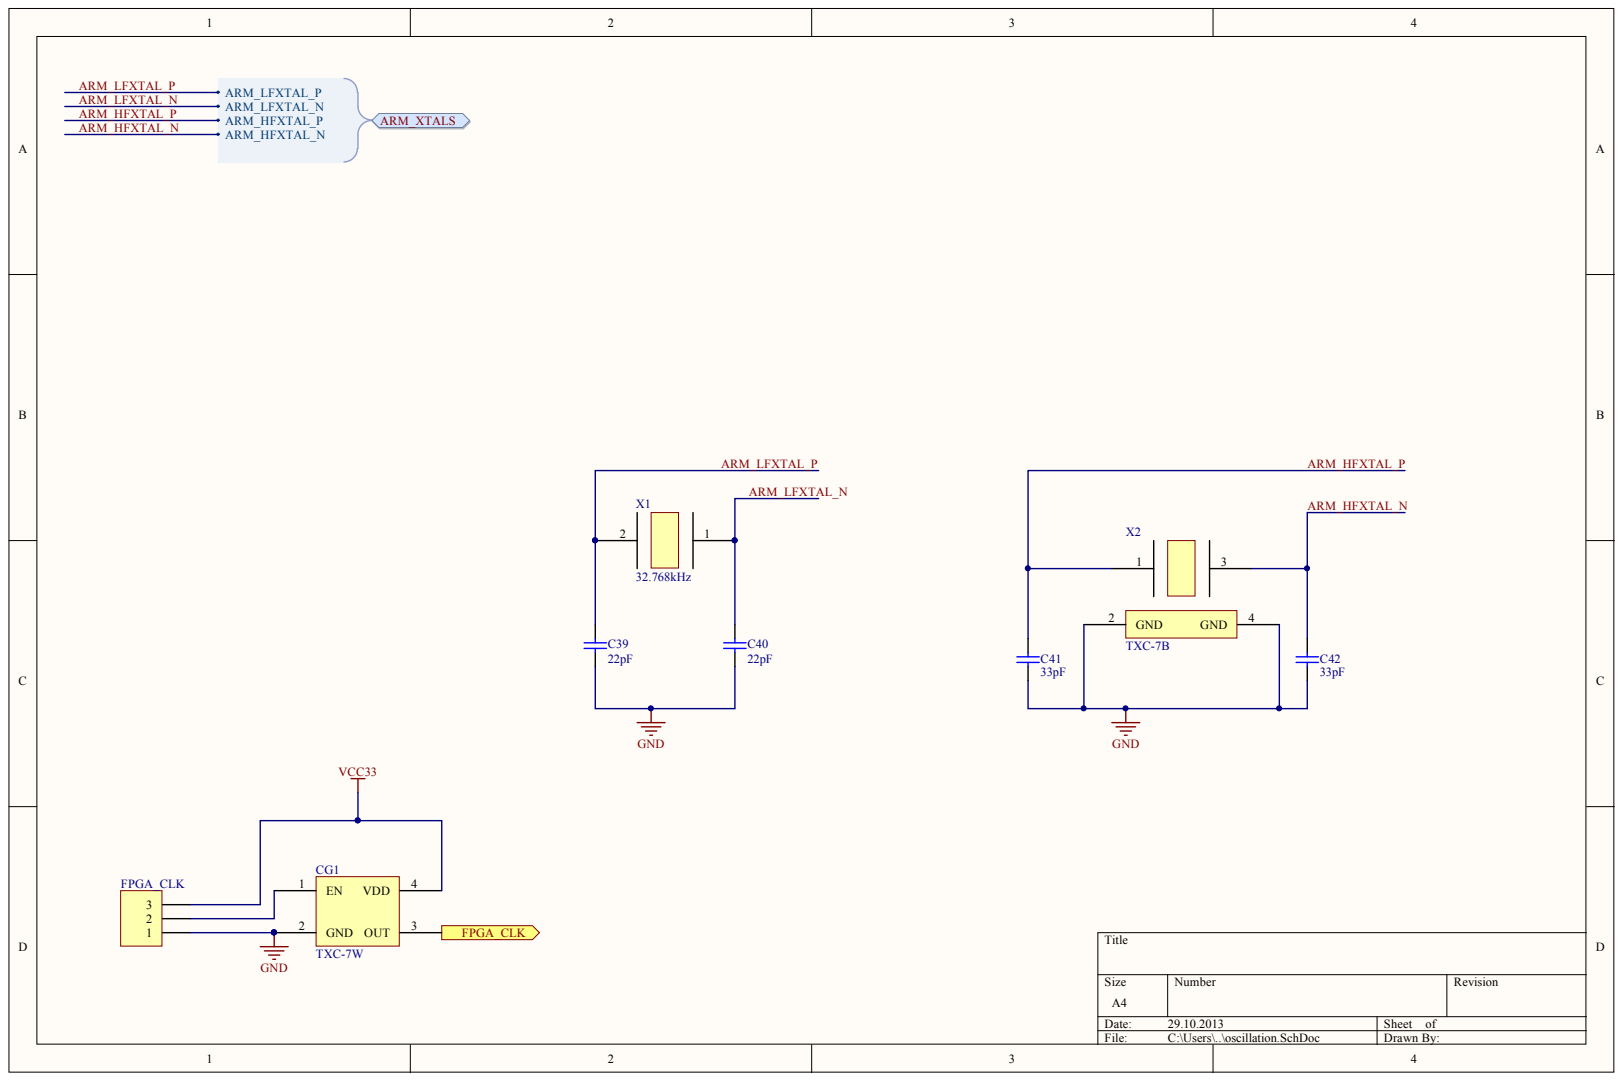
[picture p29: page 7]

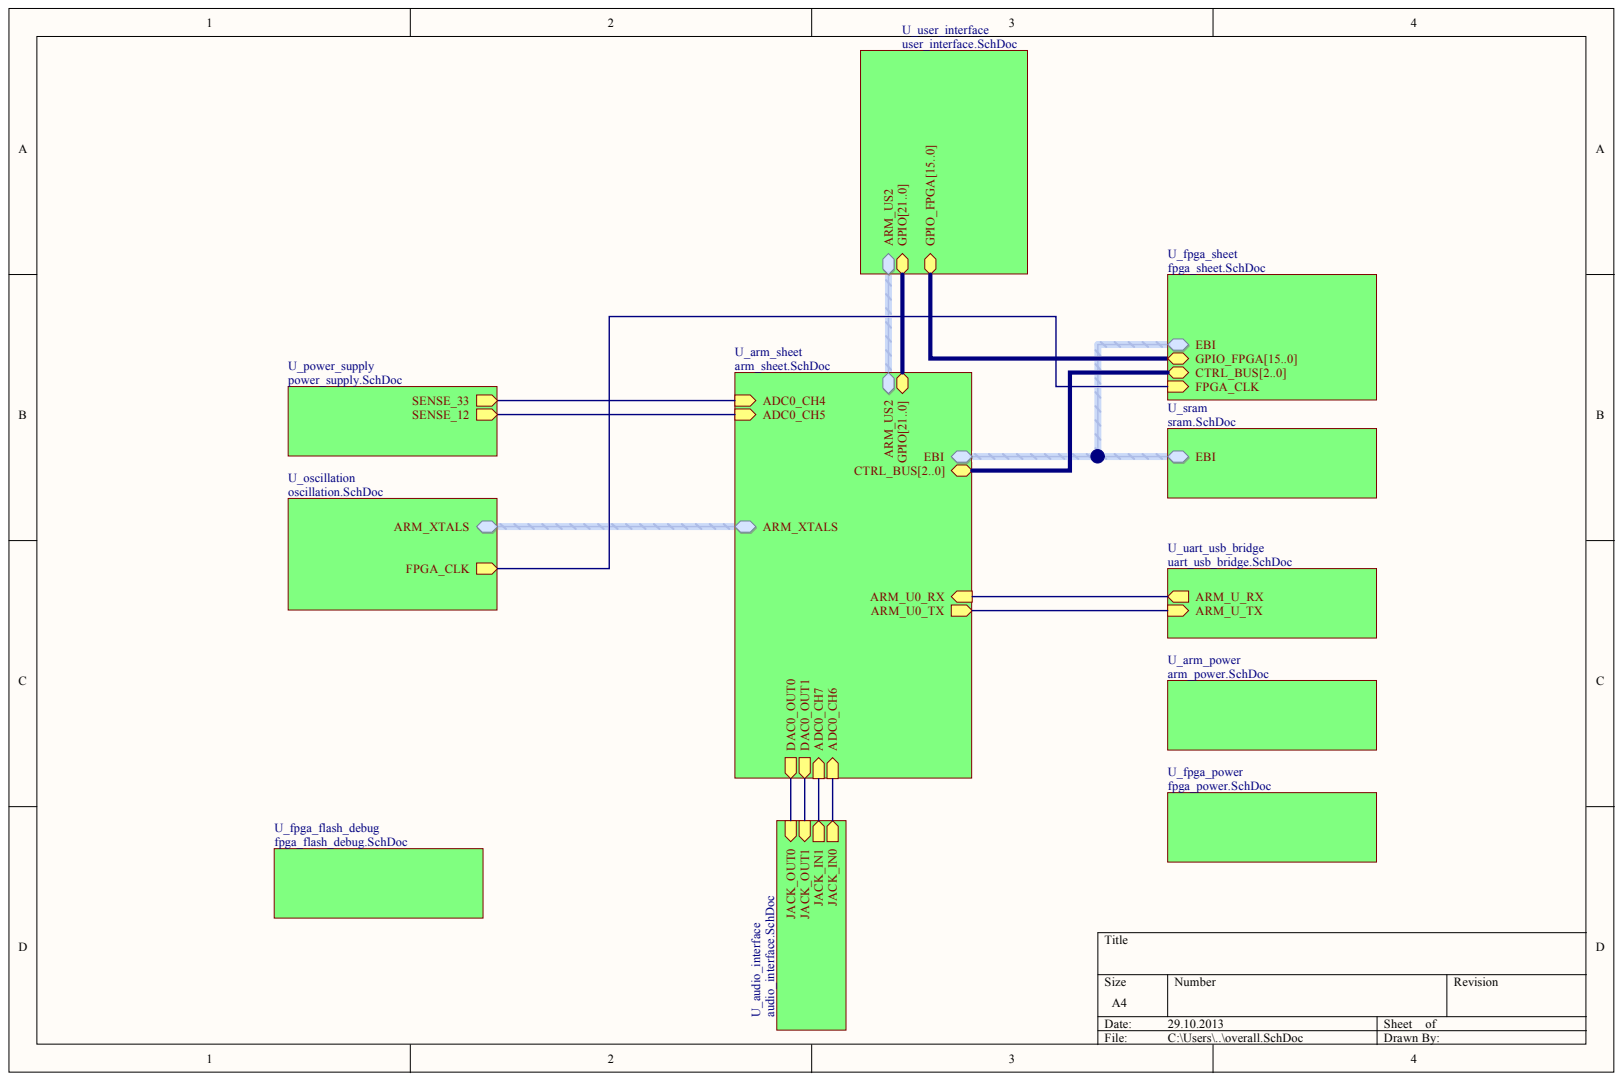
[picture p30: page 8]

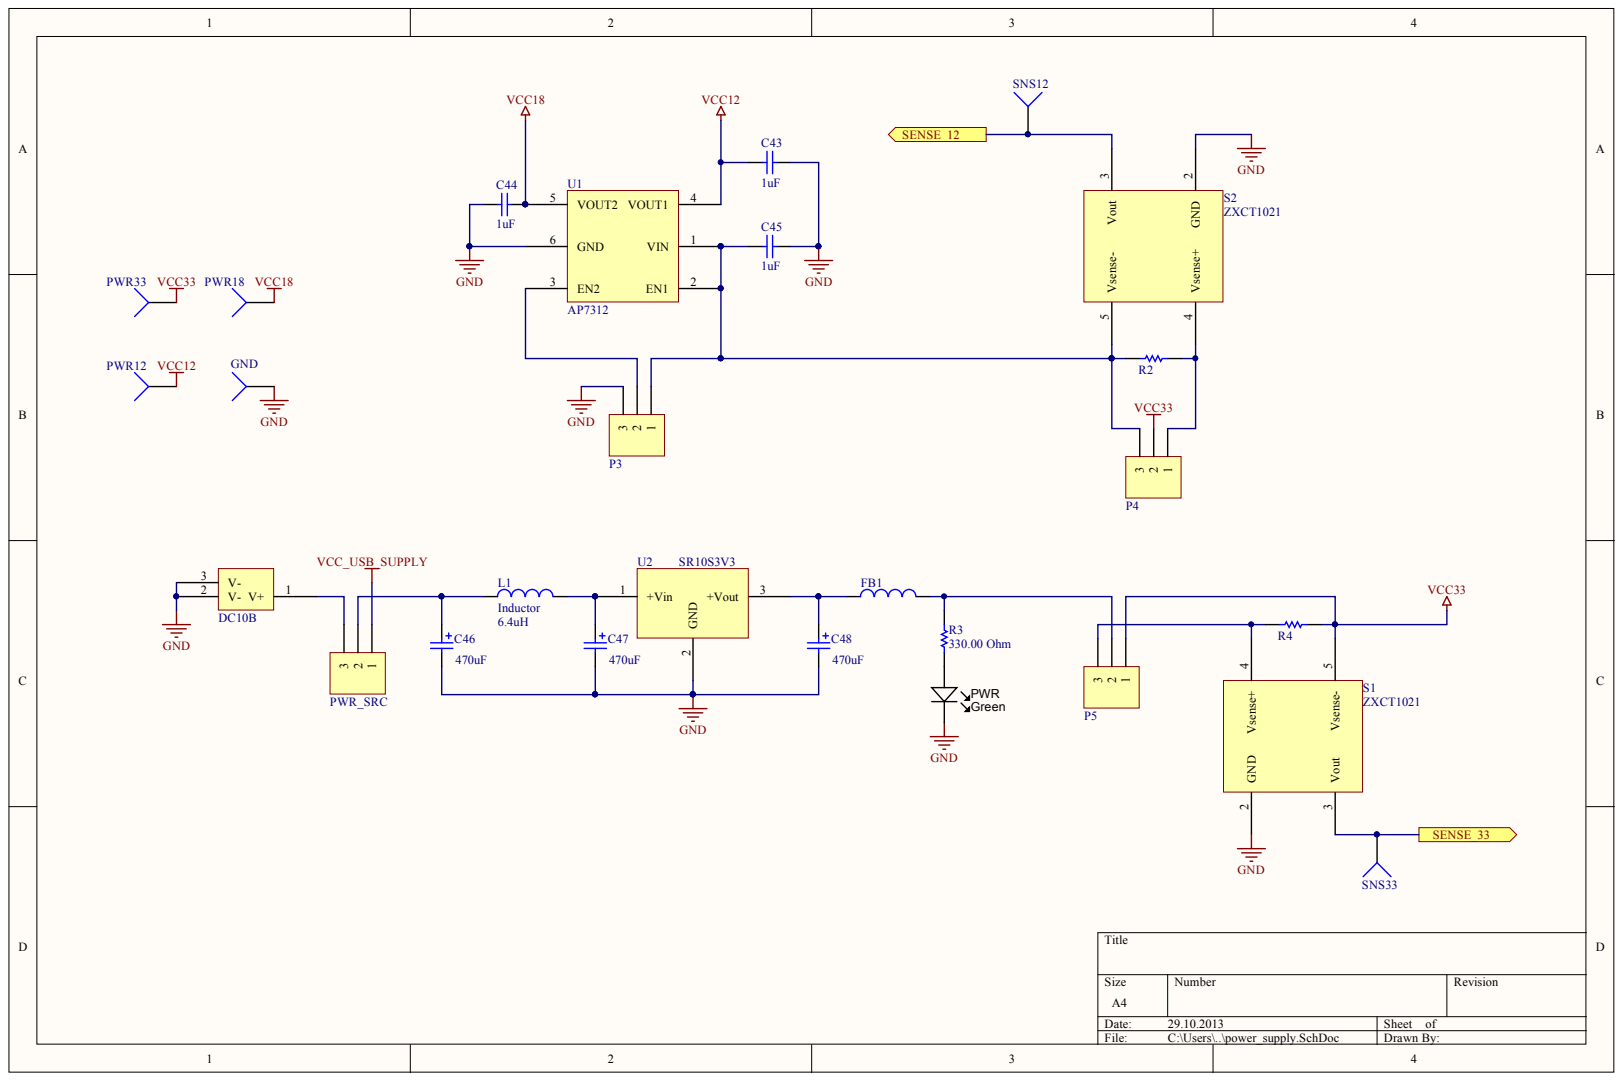
[picture p31: page 9]

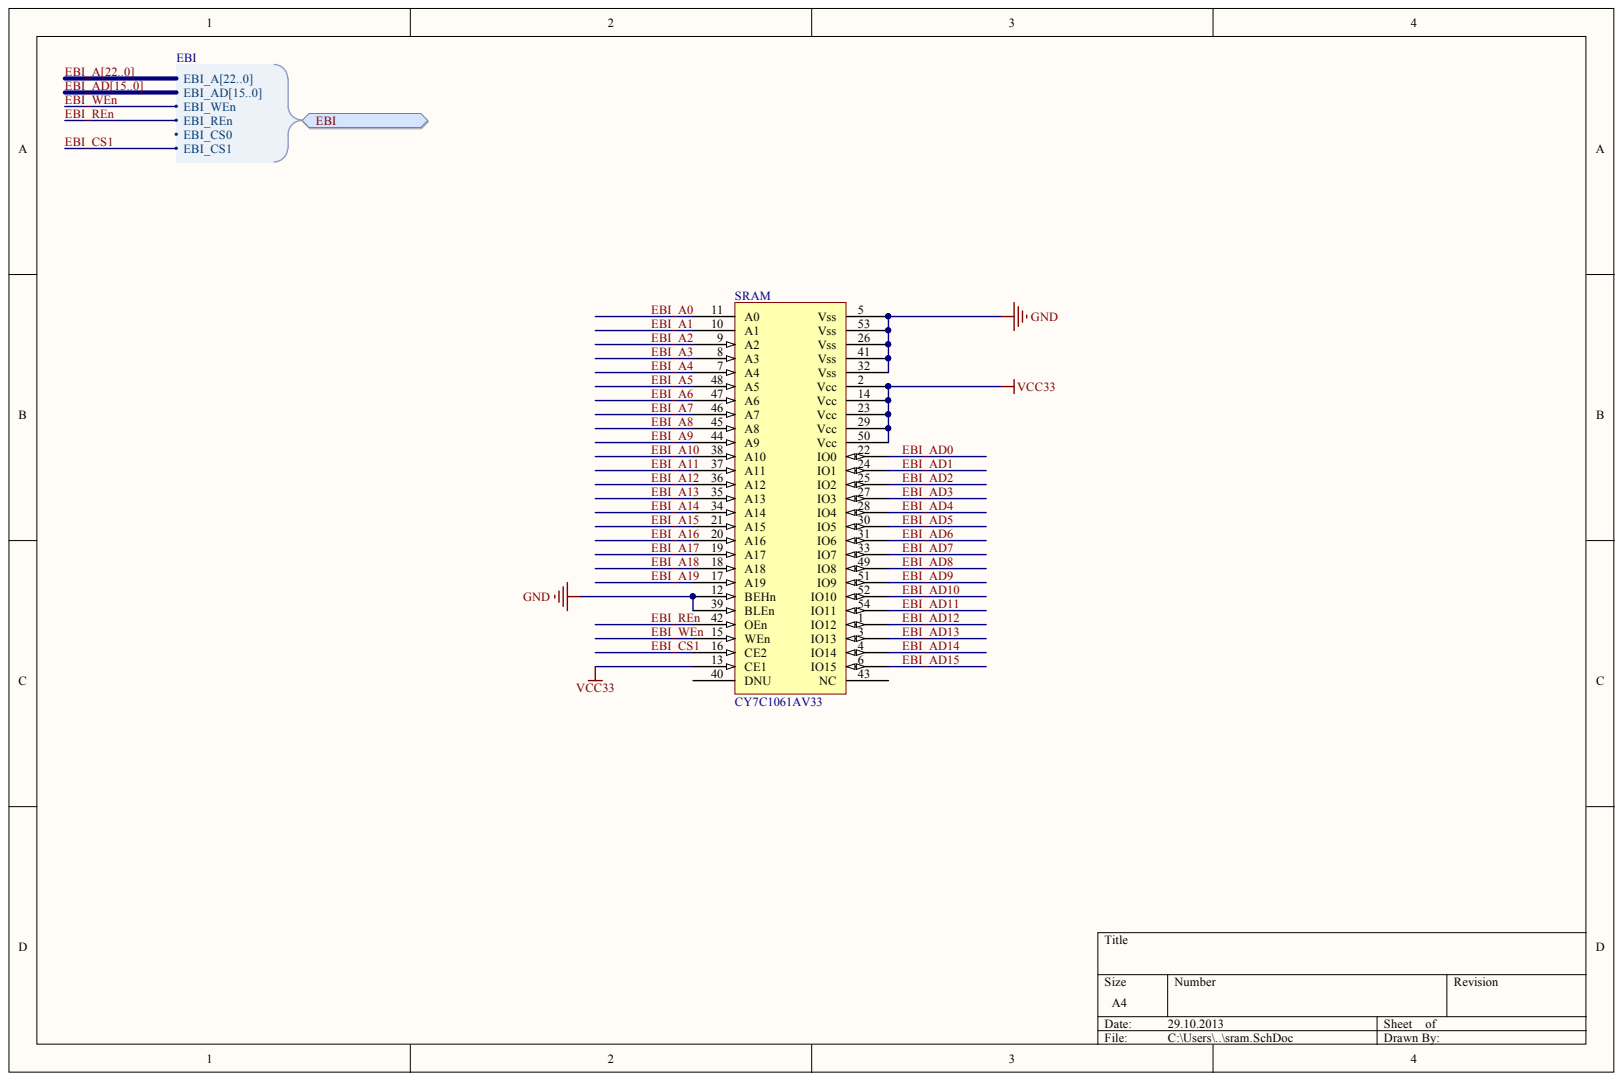
[picture p32: page 10]

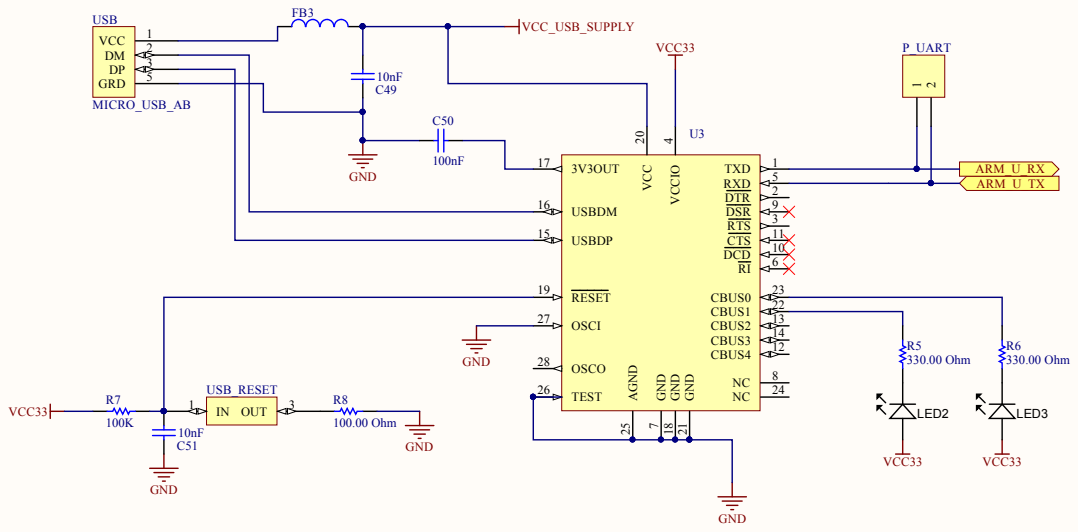
[picture p33: page 11]

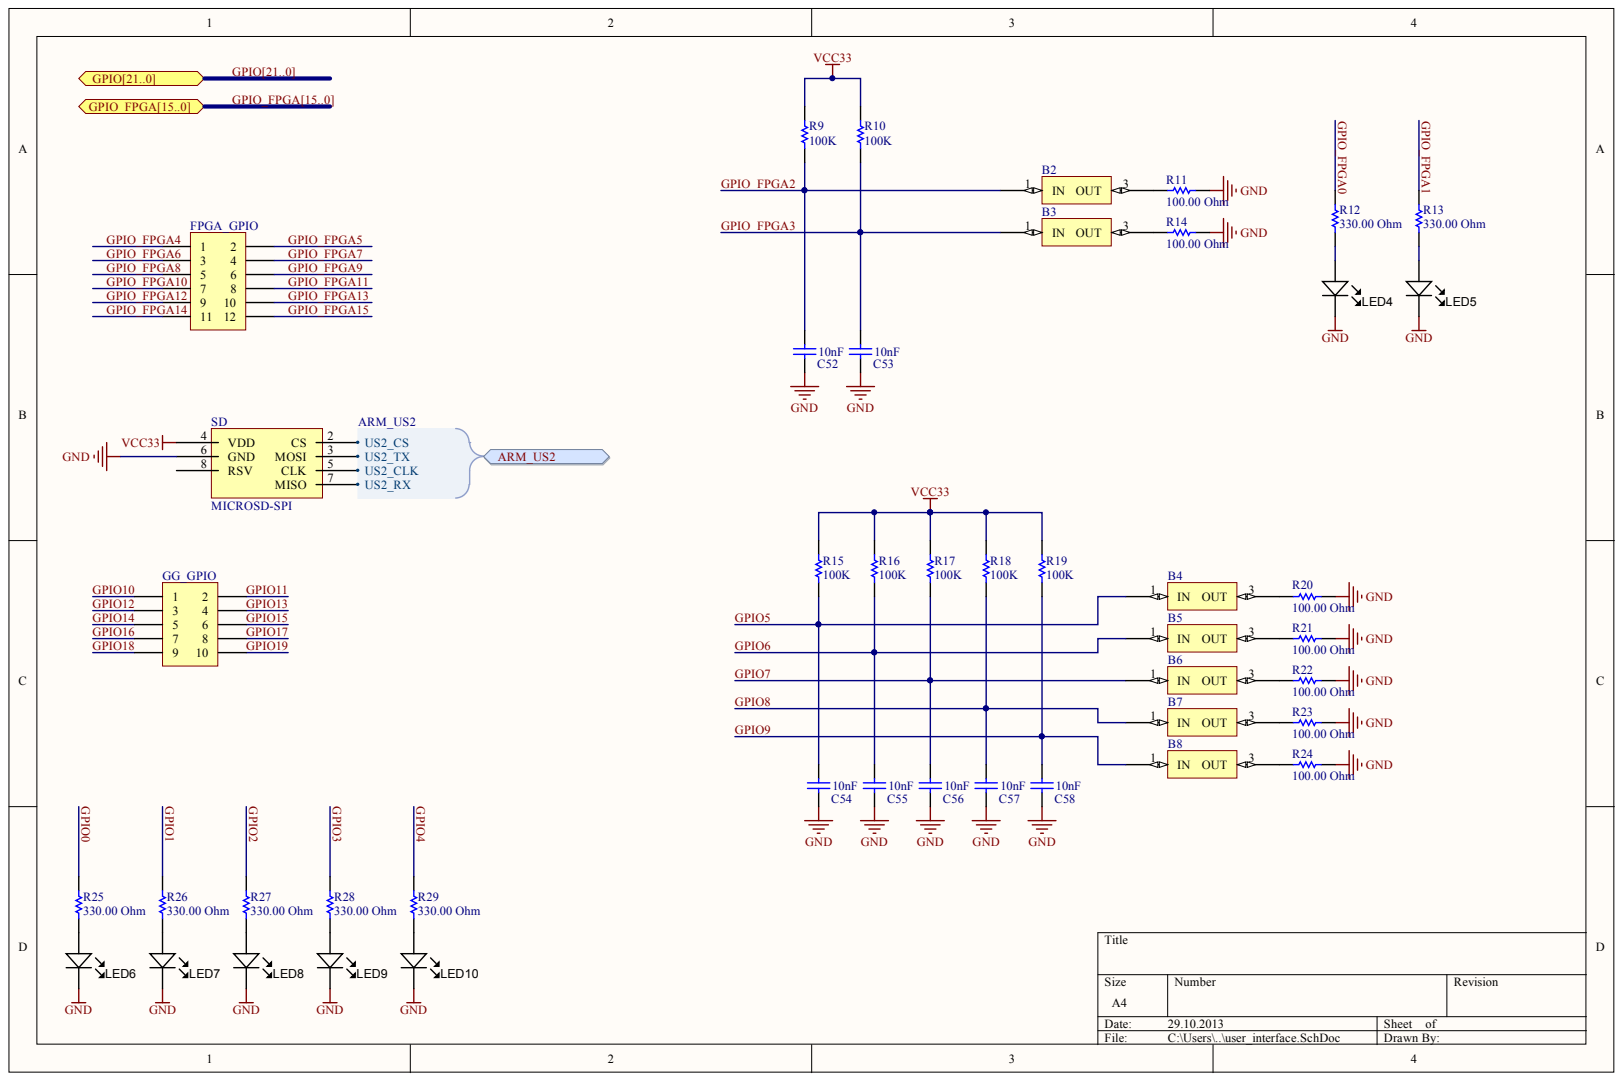
[picture p34: page 12]

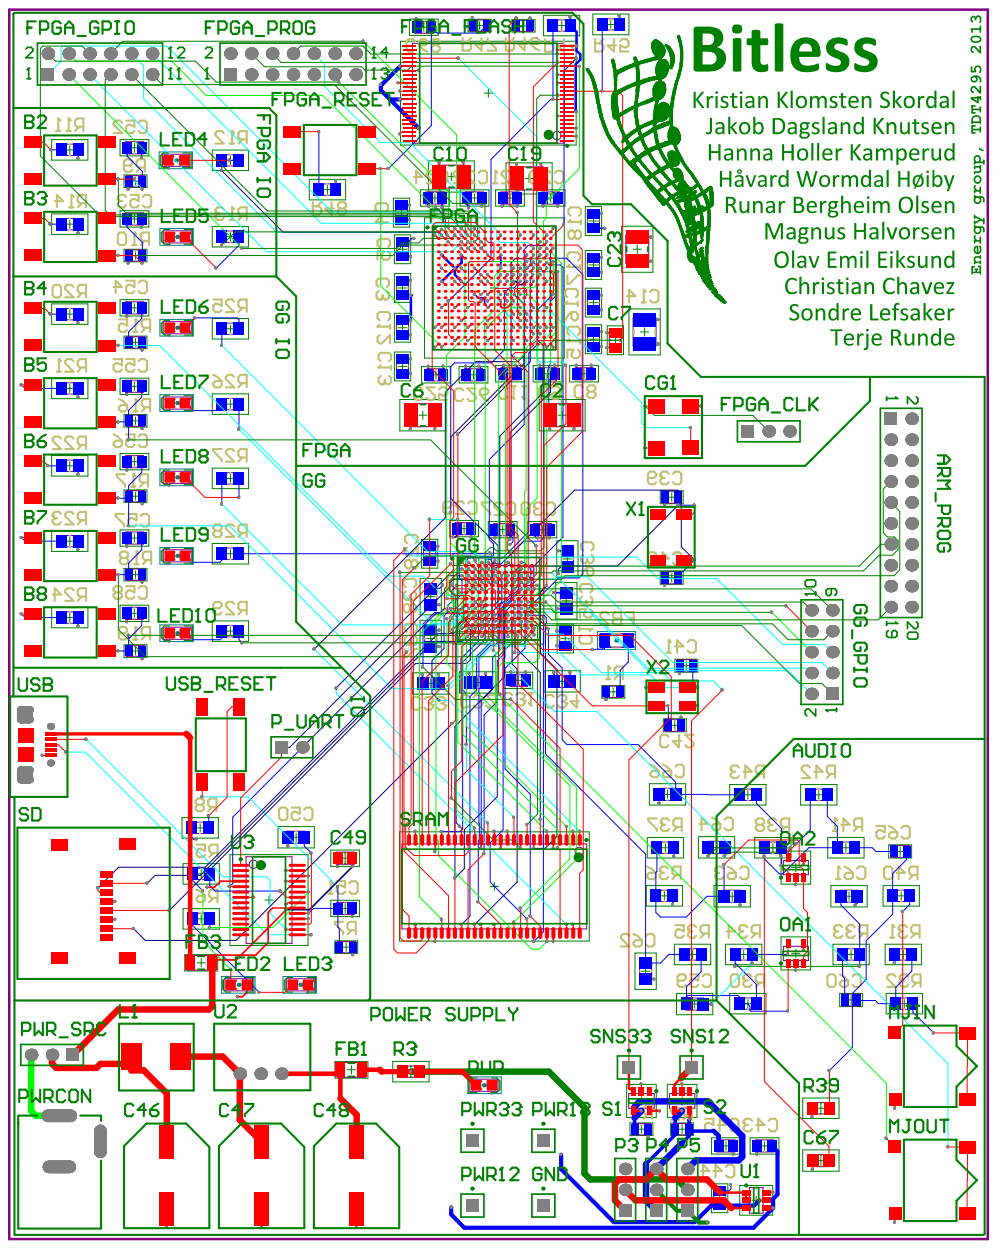
[picture p35: page 13]
