havardh/bitless/(list of files, drawings)

Other design files:
pcb/take1/arm_power.SchDoc
pcb/take1/arm_sheet.SchDoc
pcb/take1/audio_interface.SchDoc
pcb/take1/fpga_flash_debug.SchDoc
pcb/take1/fpga_power.SchDoc
pcb/take1/fpga_sheet.SchDoc
pcb/take1/MICROSD.PcbLib
pcb/take1/MICROSD.SchLib
pcb/take1/MICROUSB.PcbLib
pcb/take1/MICROUSB.SchLib
pcb/take1/oscillation.SchDoc
pcb/take1/overall.SchDoc
pcb/take1/pcb.PcbDoc
pcb/take1/pcb_take1.PcbDoc
pcb/take1/pcb_take2-1.PcbDoc
pcb/take1/pcb_take2.PcbDoc
pcb/take1/power_supply.SchDoc
pcb/take1/PowerConnector.SchLib
pcb/take1/SR10S3V3_Footprint.PcbLib
pcb/take1/SR10S3V3_Schematic.SchLib
pcb/take1/sram.SchDoc
pcb/take1/take1.PrjPcb
pcb/take1/uart_usb_bridge.SchDoc
pcb/take1/user_interface.SchDoc
pcb/take1/XCF16PVOG48C.PcbLib
pcb/take1/XCF16PVOG48C.SchLib
