havardh/bitless/vhdl/testbenches/tb_alu.vhd

--------------------------------------------------------------------------------
-- Company: 
-- Engineer:
--
-- Create Date:   14:53:20 11/03/2013
-- Design Name:   
-- Module Name:   Z:/tdt4295/vhdl/testbenches/tb_alu.vhd
-- Project Name:  ProsjektetTDT4295
-- Target Device:  
-- Tool versions:  
-- Description:   
-- 
-- VHDL Test Bench Created by ISE for module: alu
-- 
-- Dependencies:
-- 
-- Revision:
-- Revision 0.01 - File Created
-- Additional Comments:
--
-- Notes: 
-- This testbench has been automatically generated using types std_logic and
-- std_logic_vector for the ports of the unit under test.  Xilinx recommends
-- that these types always be used for the top-level I/O of a design in order
-- to guarantee that the testbench will bind correctly to the post-implementation 
-- simulation model.
--------------------------------------------------------------------------------
LIBRARY ieee;
USE ieee.std_logic_1164.ALL;
use ieee.std_logic_arith.ALL;

library work;
use work.core_constants.all;
 
-- Uncomment the following library declaration if using
-- arithmetic functions with Signed or Unsigned values
--USE ieee.numeric_std.ALL;
 
ENTITY tb_alu IS
END tb_alu;
 
ARCHITECTURE behavior OF tb_alu IS 
 
    -- Component Declaration for the Unit Under Test (UUT)
 
    COMPONENT alu
    PORT(
         cpu_clk : IN  std_logic;
         cpu_input_register_1 : IN  std_logic_vector(15 downto 0);
         cpu_input_register_2 : IN  std_logic_vector(15 downto 0);
         cpu_input_const : IN  std_logic_vector(31 downto 0);
         cpu_input_const_w : IN  std_logic;
         operation : IN  alu_operation;
         result : OUT  std_logic_vector(31 downto 0);
         flags : OUT  alu_flags
        );
    END COMPONENT;
    

   --Inputs
   signal cpu_clk : std_logic := '0';
   signal cpu_input_register_1 : std_logic_vector(15 downto 0) := (others => '0');
   signal cpu_input_register_2 : std_logic_vector(15 downto 0) := (others => '0');
   signal cpu_input_const : std_logic_vector(31 downto 0) := (others => '0');
   signal cpu_input_const_w : std_logic := '0';
   signal operation : alu_operation;

 	--Outputs
   signal result : std_logic_vector(31 downto 0);
   signal flags : alu_flags;

   -- Clock period definitions
   constant cpu_clk_period : time := 10 ns;
	
	--helper signals
	signal helper1, helper2, helper3 : std_logic_vector(31 downto 0);
 
BEGIN
 
	-- Instantiate the Unit Under Test (UUT)
   uut: alu PORT MAP (
          cpu_clk => cpu_clk,
          cpu_input_register_1 => cpu_input_register_1,
          cpu_input_register_2 => cpu_input_register_2,
          cpu_input_const => cpu_input_const,
          cpu_input_const_w => cpu_input_const_w,
          operation => operation,
          result => result,
          flags => flags
        );

   cpu_clk_process :process
   begin
		cpu_clk <= '0';
		wait for cpu_clk_period/2;
		cpu_clk <= '1';
		wait for cpu_clk_period/2;
   end process;
 

   -- Stimulus process
   stim_proc: process
   begin		
      -- hold reset state for 100 ns.
      wait for 100 ns;	


      -- insert stimulus here 
		
		operation 				 <= ALU_ADD;
		cpu_input_register_1  <= "0000000000000001";
      cpu_input_register_2  <= "0000000000000001";
		wait for cpu_clk_period/2;
		assert result = x"00000002" report "ADD not working!";
		
		operation 				 <= ALU_ADD;
		cpu_input_register_1  <= "1111111111111111";
      cpu_input_register_2  <= "0000000000000010";
		wait for cpu_clk_period/2;
		assert result = x"00000001" report "Result of xFFFF + 2 is not 1!";
		assert flags.overflow = '1' report "Overflow not set";
		
		operation 				 <= ALU_SUB;
		cpu_input_register_1  <= "0111111111111111";
      cpu_input_register_2  <= "0000000000000010";
		wait for cpu_clk_period/2;
		assert result = x"00007FFD" report "SUB not working";
		
		operation 				 <= ALU_OR;
		cpu_input_register_1  <= "0101010101010101";
      cpu_input_register_2  <= "1010101010101010";
		wait for cpu_clk_period/2;
		wait for cpu_clk_period/2;
		assert result = x"FFFFFFFF" report "OR not working!";
		
		operation 				 <= ALU_OR;
		cpu_input_register_1  <= "0000000000001100";
      cpu_input_register_2  <= "0000000000000110";
		wait for cpu_clk_period/2;
		assert result = x"0000000E" report "OR not working!";
		
		operation 				 <= ALU_MUL;
		cpu_input_register_1  <= "0000000000000001";
      cpu_input_register_2  <= "0000000000000001";
		wait for cpu_clk_period/2;
		assert result = x"00000001" report "MUL not working!";
	
		operation 				 <= ALU_MUL;
		cpu_input_register_1  <= "0000000000000111";
      cpu_input_register_2  <= "0000000000000101";
		wait for cpu_clk_period/2;
		assert result = x"00000023" report "MUL not working!";
		
		operation 				 <= ALU_MUL;
		cpu_input_register_1  <= "1111111111111001";
      cpu_input_register_2  <= "0000000000000101";
		wait for cpu_clk_period/2;
		assert result = x"FFFFFFDD" report "MUL not working!";
		
		operation 				 <= ALU_AND;
		cpu_input_register_1  <= "1111111111111001";
      cpu_input_register_2  <= "0000000000000101";
		wait for cpu_clk_period/2;
		assert result = x"00000001" report "AND isn't working";
		
		operation 				 <= ALU_AND;
		cpu_input_register_1  <= "1111111111111001";
      cpu_input_register_2  <= "0000000000000010";
		wait for cpu_clk_period/2;
		assert result = x"00000000" report "AND isn't working";
		assert flags.zero = '1' report "AND zero flag isn't working";
		
		operation 				 <= ALU_AND;
		cpu_input_register_1  <= "1111111111111001";
      cpu_input_register_2  <= "1000000000000010";
		wait for cpu_clk_period/2;
		assert result = x"FFFF8000" report "AND isn't working";
		assert flags.negative = '1' report "AND negative flag isn't working";
		
		operation 				 <= ALU_XOR;
		cpu_input_register_1  <= "0000000110011001";
      cpu_input_register_2  <= "0000000110011010";
		wait for cpu_clk_period/2;
		assert result = x"00000003" report "XOR isn't working";
		assert flags.negative = '0' report "XOR negative flag isn't working";
		
		operation 				 <= ALU_XOR;
		cpu_input_register_1  <= "0000000110011001";
      cpu_input_register_2  <= "1000000110011010";
		wait for cpu_clk_period/2;
		assert result = x"FFFF8003" report "XOR isn't working";
		assert flags.negative = '1' report "XOR negative flag isn't working";
		
		operation 				 <= ALU_NAND;
		cpu_input_register_1  <= "0000000011000000";
      cpu_input_register_2  <= "1111111111111111";
		wait for cpu_clk_period/2;
		assert result = "11111111111111111111111100111111" report "NAND isn't working";
		
		operation 				 <= ALU_NAND;
		cpu_input_register_1  <= "0000000000000011";
      cpu_input_register_2  <= "1111111111111111";
		wait for cpu_clk_period/2;
		assert result = x"FFFFFFFC" report "NAND isn't working";
		
		operation 				 <= ALU_NOR;
		cpu_input_register_1  <= "0101010101010101";
      cpu_input_register_2  <= "1010101010101010";
		wait for cpu_clk_period/2;
		wait for cpu_clk_period/2;
		assert result = x"00000000" report "NOR not working!";
		
		operation 				 <= ALU_NOR;
		cpu_input_register_1  <= "0000000000001100";
      cpu_input_register_2  <= "0000000000000110";
		wait for cpu_clk_period/2;
		assert result = x"FFFFFFF1" report "NOR not working!";
		
		operation 				 <= ALU_MOVE;
		cpu_input_register_1  <= "0000000000001100";
      cpu_input_register_2  <= "0000000000000110";
		wait for cpu_clk_period/2;
		assert result = x"0000000C" report "MOVE not working!";
		
		operation 				 <= ALU_MOVE;
      cpu_input_register_1  <= "0000000000000110";
		cpu_input_register_2  <= "0000000000001100";
		wait for cpu_clk_period/2;
		assert result = x"00000006" report "MOVE not working!";
		
		
		operation 				 <= ALU_MOVE_NEGATIVE;
      cpu_input_register_1  <= "0000000000000110";
		cpu_input_register_2  <= "0000000000001100";
		wait for cpu_clk_period/2;
		assert result = x"FFFFFFF9" report "MOVE_NEG not working!";
		
		operation 				 <= ALU_MOVE_NEGATIVE;
		cpu_input_register_1  <= "0000000000001100";
      cpu_input_register_2  <= "0000000000000110";
		wait for cpu_clk_period/2;
		assert result = x"FFFFFFF3" report "MOVE_NEG not working!";

		operation				<= ALU_FIXED_TO_FLOAT;
		cpu_input_register_1	<= x"0002"; --initial value 2 converted
		wait for cpu_clk_period/2;
		assert result = "00000000000000000100000000000000" report "Fix_to_float not working!";
		
		operation				<= ALU_FIXED_TO_FLOAT;
		cpu_input_register_1	<= "0000011001100000"; --random value which converts fine but I haven't calcualted which number it actually is
		wait for cpu_clk_period/2;
		assert result = "00000000000000000110011001100000" report "Fix_to_float not working!";
		
		operation				<= ALU_FIXED_TO_FLOAT;
		cpu_input_register_1	<= "1111111111110011"; --random negative number which also converts fine
		wait for cpu_clk_period/2;
		assert result = "11111111111111111100101010000000" report "Fix_to_float not working!";

		operation				<= ALU_FLOAT_TO_FIXED;
		cpu_input_register_1	<= "0100000000000000"; --initial 2 converted back
		wait for cpu_clk_period/2;
		assert result = x"00000002" report "Float_to_fix not working!";
		
		operation				<= ALU_FLOAT_TO_FIXED;
		cpu_input_register_1	<= "0110011001100000"; --random number converted back
		wait for cpu_clk_period/2;
		assert result = "00000000000000000000011001100000" report "Float_to_fix not working!";
		
		operation				<= ALU_FLOAT_TO_FIXED;
		cpu_input_register_1	<= "1100101010000000"; --random negative number converted back
		wait for cpu_clk_period/2;
		assert result = "11111111111111111111111111110011" report "Float_to_fix not working!";
		
		--initial values for fp tests. 3 and 5. fp values stored in helper1 and 2
		operation				<= ALU_FIXED_TO_FLOAT;
		cpu_input_register_1	<= x"0003"; 
		wait for cpu_clk_period/2;
		helper1 <= result;
		
		operation				<= ALU_FIXED_TO_FLOAT;
		cpu_input_register_1	<= x"0005"; 
		wait for cpu_clk_period/2;
		helper2 <= result;
		wait for cpu_clk_period;
		
		--testing fp multiply, 5*3=15
		operation 				 <= FP_MUL;
		cpu_input_register_1  <= helper1(15 downto 0);
		cpu_input_register_2  <= helper2(15 downto 0);
		wait for cpu_clk_period/2;
		helper3 <= result;
		wait for cpu_clk_period;
		operation				<= ALU_FLOAT_TO_FIXED;
		cpu_input_register_1	<= helper3(15 downto 0);
		wait for cpu_clk_period/2;
		assert result = x"0000000F" report "fp_mul not working!";
		
		--testing fp sub 3-5=-2
		wait for cpu_clk_period;
		operation 				 <= FP_SUB;
		cpu_input_register_1  <= helper1(15 downto 0);
		cpu_input_register_2  <= helper2(15 downto 0);
		wait for cpu_clk_period/2;
		helper3 <= result;
		wait for cpu_clk_period;
		operation				<= ALU_FLOAT_TO_FIXED;
		cpu_input_register_1	<= helper3(15 downto 0);
		wait for cpu_clk_period/2;
		assert result = x"FFFFFFFE" report "fp_sub not working!";
		
		--testing fp add 3+5=8
		wait for cpu_clk_period;
		operation 				 <= FP_ADD;
		cpu_input_register_1  <= helper1(15 downto 0);
		cpu_input_register_2  <= helper2(15 downto 0);
		wait for cpu_clk_period/2;
		helper3 <= result;
		wait for cpu_clk_period;
		operation				<= ALU_FLOAT_TO_FIXED;
		cpu_input_register_1	<= helper3(15 downto 0);
		wait for cpu_clk_period/2;
		assert result = x"00000008" report "fp_add not working!";
		
		--initial values for fp tests. 117 and 12. fp values stored in helper1 and 2
		operation				<= ALU_FIXED_TO_FLOAT;
		cpu_input_register_1	<= "0000000001110101"; 
		wait for cpu_clk_period/2;
		helper1 <= result;
		
		operation				<= ALU_FIXED_TO_FLOAT;
		cpu_input_register_1	<= "0000000000001100"; 
		wait for cpu_clk_period/2;
		helper2 <= result;
		wait for cpu_clk_period;
	
		--testing fp multiply, 117*12=1404
		operation 				 <= FP_MUL;
		cpu_input_register_1  <= helper1(15 downto 0);
		cpu_input_register_2  <= helper2(15 downto 0);
		wait for cpu_clk_period/2;
		helper3 <= result;
		wait for cpu_clk_period;
		operation				<= ALU_FLOAT_TO_FIXED;
		cpu_input_register_1	<= helper3(15 downto 0);
		wait for cpu_clk_period/2;
		assert result = "00000000000000000000010101111100" report "fp_mul not working!";
		
		--testing fp sub 117-12=105
		wait for cpu_clk_period;
		operation 				 <= FP_SUB;
		cpu_input_register_1  <= helper1(15 downto 0);
		cpu_input_register_2  <= helper2(15 downto 0);
		wait for cpu_clk_period/2;
		helper3 <= result;
		wait for cpu_clk_period;
		operation				<= ALU_FLOAT_TO_FIXED;
		cpu_input_register_1	<= helper3(15 downto 0);
		wait for cpu_clk_period/2;
		assert result = x"00000069" report "fp_sub not working!";
		
		--testing fp add 117+12=129
		wait for cpu_clk_period;
		operation 				 <= FP_ADD;
		cpu_input_register_1  <= helper1(15 downto 0);
		cpu_input_register_2  <= helper2(15 downto 0);
		wait for cpu_clk_period/2;
		helper3 <= result;
		wait for cpu_clk_period;
		operation				<= ALU_FLOAT_TO_FIXED;
		cpu_input_register_1	<= helper3(15 downto 0);
		wait for cpu_clk_period/2;
		assert result = x"00000081" report "fp_add not working!";
		
		--initial values for fp tests. 316 and -19. fp values stored in helper1 and 2
		operation				<= ALU_FIXED_TO_FLOAT;
		cpu_input_register_1	<= x"013C"; 
		wait for cpu_clk_period/2;
		helper1 <= result;
		
		operation				<= ALU_FIXED_TO_FLOAT;
		cpu_input_register_1	<= "1111111111110100"; 
		wait for cpu_clk_period/2;
		helper2 <= result;
		wait for cpu_clk_period;
		
		--testing fp multiply, 316*(-12)=-3792
		operation 				 <= FP_MUL;
		cpu_input_register_1  <= helper1(15 downto 0);
		cpu_input_register_2  <= helper2(15 downto 0);
		wait for cpu_clk_period/2;
		helper3 <= result;
		wait for cpu_clk_period;
		operation				<= ALU_FLOAT_TO_FIXED;
		cpu_input_register_1	<= helper3(15 downto 0);
		wait for cpu_clk_period/2;
		assert result = "11111111111111111111000100110000" report "fp_mul not working!";
		
		--testing fp sub 316-(-12)=328
		wait for cpu_clk_period;
		operation 				 <= FP_SUB;
		cpu_input_register_1  <= helper1(15 downto 0);
		cpu_input_register_2  <= helper2(15 downto 0);
		wait for cpu_clk_period/2;
		helper3 <= result;
		wait for cpu_clk_period;
		operation				<= ALU_FLOAT_TO_FIXED;
		cpu_input_register_1	<= helper3(15 downto 0);
		wait for cpu_clk_period/2;
		assert result = x"00000148" report "fp_sub not working!";
		
		--testing fp add 316+(-12)=304
		wait for cpu_clk_period;
		operation 				 <= FP_ADD;
		cpu_input_register_1  <= helper1(15 downto 0);
		cpu_input_register_2  <= helper2(15 downto 0);
		wait for cpu_clk_period/2;
		helper3 <= result;
		wait for cpu_clk_period;
		operation				<= ALU_FLOAT_TO_FIXED;
		cpu_input_register_1	<= helper3(15 downto 0);
		wait for cpu_clk_period/2;
		assert result = x"00000130" report "fp_add not working!";


		


      wait;
   end process;

END;
