havardh/bitless/sw/modules/uart/inc/bl_uart.h

#ifndef _SERIAL_H_
#define _SERIAL_H_

#include <stdint.h>
#include <stdbool.h>
#include <stdio.h>
#include "em_device.h"
#include "em_chip.h"
#include "em_emu.h"
#include "em_cmu.h"
#include "em_gpio.h"
#include "em_usart.h"

/* Define termination character */
#define TERMINATION_CHAR    '.'

/* Declare a circular buffer structure to use for Rx and Tx queues */
#define BUFFERSIZE          256

typedef volatile struct {
    uint8_t  data[BUFFERSIZE];  /* data buffer */
    uint32_t rdI;               /* read index */
    uint32_t wrI;               /* write index */
    uint32_t pendingBytes;      /* count of how many bytes are not yet handled */
    bool     overflow;          /* buffer overflow indicator */
} circularBuffer;

/* UART Transfer / Receive methods */
void UART_Init(void);
void UART_PutChar(uint8_t charPtr);
uint8_t UART_GetChar(void);
void UART_PutData(uint8_t * dataPtr, uint32_t dataLen);
uint32_t UART_GetData(uint8_t * dataPtr, uint32_t dataLen);

/* UART Terminal commands */
void UART_ClearScreen(void);
void UART_SetCursor(int row, int col);

#endif // _SERIAL_H_
