havardh/bitless/(commit log)

2013-09-04 Started working on PCB layout. Added EBI bus and ARM debug header.
    [arm_sheet.SchDoc, fpga_power.SchDoc, fpga_sheet.SchDoc, take1.PrjPcb]
2013-09-10 Collected all sheets under a common overall sheet
    [arm_sheet.SchDoc, fpga_sheet.SchDoc, overall.SchDoc, take1.PrjPcb]
2013-09-10 Debug header
    [arm_sheet.SchDoc]
2013-09-10 Added SR10S3v3
    [SR10S3V3_Footprint.PcbLib, SR10S3V3_Schematic.SchLib, power_supply.SchDoc]
2013-09-11 Added PCB chapter, started a listing of required components.
2013-09-11 Altium commit
    [fpga_sheet.SchDoc]
2013-09-11 Added low-frequency crystal to ARM.
    [oscillation.SchDoc]
2013-09-11 Updated toplevel and ARM sheet to include LF-crystal.
    [arm_sheet.SchDoc, overall.SchDoc, take1.PrjPcb]
2013-09-12 Added and attached HF crystal to ARM.
    [arm_sheet.SchDoc, oscillation.SchDoc]
2013-09-12 Added all FPGA banks
    [fpga_power.SchDoc, fpga_sheet.SchDoc, take1.PrjPcb]
2013-09-12 Added PCB TODO with various crystal info that needs to be verified.
2013-09-15 Fix links to ARM documents
2013-09-15 Added decoupling for FPGA.
    [fpga_power.SchDoc]
2013-09-15 Draw some lines on power supply.
    [power_supply.SchDoc]
2013-09-16 Decoupling for ARM MCU.
    [arm_power.SchDoc, arm_sheet.SchDoc, fpga_power.SchDoc, take1.PrjPcb]
2013-09-16 Added headers
    [power_supply.SchDoc]
2013-09-17 Added USB-UART bridge, missing a ferrite board on the 5v supply from the usb header. Also need to figure out if it is at all possible to use the usb for powering the bridge if the rest of the system 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
    [fpga_sheet.SchDoc, overall.SchDoc, take1.PrjPcb, uart_usb_bridge.SchDoc]
2013-09-17 Added EBI bus interface to FPGA
    [fpga_sheet.SchDoc, overall.SchDoc, uart_usb_bridge.SchDoc]
2013-09-17 FPGA JTag header
    [fpga_sheet.SchDoc]
2013-09-17 Fix VHDL file naming
    [core.vhd, pipeline.vhd]
2013-09-17 pwr supply update
    Conflicts:
    pcb/take1/power_supply.SchDoc
    [SR10S3V3_Footprint.PcbLib, SR10S3V3_Schematic.SchLib, power_supply.SchDoc]
2013-09-18 Made main run MainController. Moved blinking leds into leds controller demo with makefile.
2013-09-18 pwr supply update. Added linear regulator
    [SR10S3V3_Footprint.PcbLib, SR10S3V3_Schematic.SchLib, power_supply.SchDoc]
2013-09-22 ADCController and ADC Driver with test implemented for single conversion
2013-09-23 Fix syntax errors in core.vhd to appease ISE
    [core.vhd]
2013-09-23 Updated ADC
2013-09-24 Mapped four ADC inputs and two DAC outputs. Fixed UART bridge connections, using only two pins
    [arm_sheet.SchDoc, uart_usb_bridge.SchDoc]
2013-09-24 Mapped USART for SD card interface, moved a ADC channel
    [arm_sheet.SchDoc, take1.PrjPcb]
2013-09-24 Mapped all unused GPIO pins to the GPIO bus
    [arm_sheet.SchDoc]
2013-09-24 Fixed missplaced port in uart_usb_bridge
    [uart_usb_bridge.SchDoc]
2013-09-24 Added TX and RX leds to usb bridge
    [uart_usb_bridge.SchDoc]
2013-09-24 Current sense
    [fpga_power.SchDoc, overall.SchDoc, power_supply.SchDoc, sram.SchDoc, take1.PrjPcb, uart_usb_bridge.SchDoc]
2013-09-24 Fix EBI address bus width to 25 bits
    [ebi_controller.vhd, internal_bus.vhd, pipeline.vhd, toplevel.vhd]
2013-09-24 EFm32 pinout major components
    [arm_sheet.SchDoc, power_supply.SchDoc, take1.PrjPcb]
2013-09-24 GPIO bus
    [arm_sheet.SchDoc]
2013-09-25 report, power supply
2013-09-25 Added SRAM component and footprint. Added and completed sram schematic
    [SR10S3V3_Footprint.PcbLib, SR10S3V3_Schematic.SchLib, arm_sheet.SchDoc, fpga_sheet.SchDoc, sram.SchDoc]
2013-09-25 Fixed EBI_A bus width
    [fpga_sheet.SchDoc]
2013-09-25 Sequential numbering of GPIO pins, GPIO bus, and fixed a compilation problem with the sram sheet
    [arm_sheet.SchDoc, sram.SchDoc]
2013-09-25 Add missing sensitivity in adder
    [adder.vhd]
2013-09-25 Add temporary ucf with information from PCB schematics
2013-09-25 Add memory and some other stuff that synthesizes
    Also gets rid of the inout ports used for the internal bus,
    which is now replaced by two busses and some signals instead.
    Maximum frequency is now ~300 MHz, which is better than before
    things started synthesizing...
    [ebi_controller.vhd, internal_bus.vhd, pipeline.vhd]
2013-09-26 Demo of working Jack => ADC => DMA => DAC => Jack
2013-09-26 Moved common kit drivers
2013-09-26 Changed to correct FPGA (XC6SLX9 -> XC6SLX16).
    [fpga_power.SchDoc, fpga_sheet.SchDoc, take1.PrjPcb]
2013-09-26 Add memory to the ringbuffer module and insert it into the pipeline
2013-09-26 Updated PlanAhead project.
    [io_1.csv]
2013-09-26 Fixed led direction
    [uart_usb_bridge.SchDoc]
2013-09-26 Updated FPGA sheet according to the new FPGA pinout.
    [fpga_sheet.SchDoc]
2013-09-26 Removed unused USB power pins on EFM32GG.
    [arm_power.SchDoc]
2013-09-26 Added GPIO to FPGA.
    [fpga_sheet.SchDoc]
2013-09-26 Updated PlanAhead to include ARM-FPGA control bus.
    [io_1.csv]
2013-09-26 Added control bus to FPGA sheet.
    [fpga_sheet.SchDoc]
2013-09-26 Added user interface sheet
    [user_interface.SchDoc]
2013-09-26 Assigned all designators, updated overall
    [arm_power.SchDoc, fpga_sheet.SchDoc, overall.SchDoc, power_supply.SchDoc, sram.SchDoc, take1.PrjPcb, uart_usb_bridge.SchDoc, user_interface.SchDoc]
2013-09-26 Working ADC->DMA->DAC with own implementation of ADC
2013-09-26 Fix bug in fpga sheet
    [fpga_sheet.SchDoc, sram.SchDoc]
2013-09-26 Fpga sheet again
    [fpga_sheet.SchDoc]
2013-09-26 Added footprint for 60MHz oscillator.
    [SR10S3V3_Footprint.PcbLib, SR10S3V3_Schematic.SchLib, oscillation.SchDoc]
2013-09-26 Designated names
    [arm_power.SchDoc, arm_sheet.SchDoc, fpga_power.SchDoc, fpga_sheet.SchDoc, overall.SchDoc, power_supply.SchDoc, sram.SchDoc, take1.PrjPcb]
2013-09-26 Designated components
    [fpga_power.SchDoc, fpga_sheet.SchDoc, take1.PrjPcb, uart_usb_bridge.SchDoc]
2013-09-26 Added library for MicroSD Card. Not finished yet.
    [MICROSD.PcbLib, MICROSD.SchLib]
2013-09-26 MicroSD schematics added with amazing footprint. Use MICROSD_WR-CRD.
    [MICROSD.PcbLib, MICROSD.SchLib]
2013-09-26 Updated old schematics with footprints and proper pin mapping.
    [SR10S3V3_Schematic.SchLib]
2013-09-26 Updated project file.
    [take1.PrjPcb]
2013-09-27 Changed to Altium Vault capacitors to get 0805 footprints.
    [arm_power.SchDoc, arm_sheet.SchDoc, fpga_power.SchDoc, oscillation.SchDoc, power_supply.SchDoc, take1.PrjPcb, uart_usb_bridge.SchDoc, user_interface.SchDoc]
2013-09-27 Started on refactoring DMA and DAC
2013-09-28 Working ADC->DMA->DAC for refactored code.
2013-10-01 Power plu
    [PowerConnector.SchLib, pcb.PcbDoc, pcb_take2.PcbDoc, power_supply.SchDoc, take1.PrjPcb]
2013-10-01 Added implementation of SD Card to user_interface.
    [take1.PrjPcb, user_interface.SchDoc]
2013-10-01 Added power plug and power switch schematic. Updated TODO, FPGA and SRAM have a powerswitch each
    [PowerConnector.SchLib, arm_power.SchDoc, fpga_power.SchDoc, sram.SchDoc, take1.PrjPcb]
2013-10-01 Added MICROSD schematic symbol adapted for SPI. Updated overall schematic
    [MICROSD.SchLib, arm_sheet.SchDoc, fpga_power.SchDoc, overall.SchDoc, user_interface.SchDoc]
2013-10-01 Added minijacks, updated overall
    [PowerConnector.SchLib, arm_sheet.SchDoc, fpga_power.SchDoc, overall.SchDoc, user_interface.SchDoc]
2013-10-01 Changed some restistors to use Altium Vault resistors. Not done with all yet.
    [arm_power.SchDoc, power_supply.SchDoc, uart_usb_bridge.SchDoc, user_interface.SchDoc]
2013-10-02 Updated designators, fixed some complile errors
    [arm_power.SchDoc, fpga_power.SchDoc, overall.SchDoc, sram.SchDoc, uart_usb_bridge.SchDoc, user_interface.SchDoc]
2013-10-02 Resistor values
    [power_supply.SchDoc, user_interface.SchDoc]
2013-10-02 More 0805 resistors.
    [power_supply.SchDoc, user_interface.SchDoc]
2013-10-02 Added FLASH footprint and schematic.
    [SR10S3V3_Footprint.PcbLib, SR10S3V3_Schematic.SchLib]
2013-10-02 Added library for Micro-USB. Not yet finished.
    [MICROUSB.PcbLib]
2013-10-02 ADC -> DMA -> SRAM -> DMA -> DAC
2013-10-02 FPGA flash
    [fpga_flash_debug.SchDoc]
2013-10-02 USB schematics finished and placed in project.
    [MICROUSB.PcbLib, MICROUSB.SchLib, take1.PrjPcb, uart_usb_bridge.SchDoc]
2013-10-03 Refactored DMA Driver to rely on interface of FPGA and not internals.
2013-10-04 Added 0805 leds.
    [arm_power.SchDoc, arm_sheet.SchDoc, overall.SchDoc, power_supply.SchDoc, sram.SchDoc, uart_usb_bridge.SchDoc, user_interface.SchDoc]
2013-10-04 Fixed compilation problems.
    [overall.SchDoc, user_interface.SchDoc]
2013-10-05 Renamed major components.
    [arm_power.SchDoc, arm_sheet.SchDoc, fpga_power.SchDoc, fpga_sheet.SchDoc]
2013-10-05 Audio interface
    [PowerConnector.SchLib, audio_interface.SchDoc, take1.PrjPcb]
2013-10-05 Added SMD library and removed power switches.
    [fpga_power.SchDoc, oscillation.SchDoc, sram.SchDoc, take1.PrjPcb, uart_usb_bridge.SchDoc]
2013-10-05 Added footprint for 32.768kHz XTAL.
    [SR10S3V3_Footprint.PcbLib, SR10S3V3_Schematic.SchLib, oscillation.SchDoc]
2013-10-05 Added FPGA flash+debug sheet to project.
    [fpga_flash_debug.SchDoc, fpga_sheet.SchDoc, oscillation.SchDoc, take1.PrjPcb]
2013-10-05 Changed FPGA debug header to a smaller one.
    [fpga_flash_debug.SchDoc]
2013-10-05 WIP: Compilation fixes for FPGA flash etc.
    [arm_power.SchDoc, arm_sheet.SchDoc, fpga_flash_debug.SchDoc, fpga_power.SchDoc, oscillation.SchDoc, overall.SchDoc, power_supply.SchDoc, sram.SchDoc]
2013-10-05 Added footprint for 32MHz crystal.
    [SR10S3V3_Footprint.PcbLib, SR10S3V3_Schematic.SchLib, oscillation.SchDoc]
2013-10-05 Fixed some dangling pins on FTDI chip.
    [uart_usb_bridge.SchDoc]
2013-10-05 Fixed compilation errors.
    [audio_interface.SchDoc, fpga_flash_debug.SchDoc, oscillation.SchDoc, overall.SchDoc, take1.PrjPcb, uart_usb_bridge.SchDoc, user_interface.SchDoc]
2013-10-05 Locked lots of names.
    [arm_power.SchDoc, arm_sheet.SchDoc, audio_interface.SchDoc, fpga_flash_debug.SchDoc, oscillation.SchDoc, power_supply.SchDoc, sram.SchDoc, take1.PrjPcb]
2013-10-05 Fixed bug in OSC footprint.
    [SR10S3V3_Schematic.SchLib]
2013-10-05 Assembler script skeleton
    Needs actual opcode strings.
    Also included phone number.
2013-10-05 Added proper footprint for 470uF and updated schematics with these footprints. Must be verified once board is ready for print - see TODO.
    [SR10S3V3_Footprint.PcbLib, power_supply.SchDoc]
2013-10-05 Project file.
    [take1.PrjPcb]
2013-10-06 Correct footprint for ferrite beads.
    [arm_power.SchDoc, power_supply.SchDoc, uart_usb_bridge.SchDoc]
2013-10-06 Added coil footprint
2013-10-06 Updated footprints
2013-10-06 Various footprint fixes.
    [power_supply.SchDoc, uart_usb_bridge.SchDoc]
2013-10-06 Added voltage sockets.
    [power_supply.SchDoc, take1.PrjPcb]
2013-10-06 Harnessed ARM XTALS.
    [arm_sheet.SchDoc, oscillation.SchDoc, overall.SchDoc, take1.PrjPcb]
2013-10-06 Initial layout attempt.
    [pcb_take1.PcbDoc, power_supply.SchDoc, take1.PrjPcb]
2013-10-06 WIP: PCB layout.
    [pcb_take1.PcbDoc, take1.PrjPcb]
2013-10-07 Attempted to autoroute, but failed. Do we really need GPIO?
    [pcb_take1.PcbDoc, take1.PrjPcb]
2013-10-07 WIP PCB layout. Now uses 8(?) signal layers and routes 100%.
    [pcb_take1.PcbDoc, sram.SchDoc]
2013-10-08 Fixed footprint for 470uF cap, added sockets on current sensors, cleaned up power_supply sheet.
    [SR10S3V3_Footprint.PcbLib, power_supply.SchDoc, take1.PrjPcb]
2013-10-08 Included audio jack footprint into schematic component.
    [audio_interface.SchDoc]
2013-10-08 Major overhaul. Changed FPGA to LX45, updated caps, div other smaller changes.
    [SR10S3V3_Footprint.PcbLib, arm_power.SchDoc, arm_sheet.SchDoc, audio_interface.SchDoc, fpga_flash_debug.SchDoc, fpga_power.SchDoc, fpga_sheet.SchDoc, oscillation.SchDoc]
2013-10-08 Renumbered and renamed headers.
    [oscillation.SchDoc, power_supply.SchDoc, uart_usb_bridge.SchDoc]
2013-10-08 Started on PCB layout, renamed power supply sockets.
    [pcb_take2.PcbDoc, power_supply.SchDoc]
2013-10-08 Updated socket names.
    [pcb_take2.PcbDoc, power_supply.SchDoc]
2013-10-08 Placed PSU nicely.
    [pcb_take2.PcbDoc, take1.PrjPcb]
2013-10-08 User interface layout.
    [pcb_take2.PcbDoc]
2013-10-08 Added USB and SD stuff.
    [pcb_take2.PcbDoc]
2013-10-08 Laid out entire board, now let's do some routing.
    [pcb_take2.PcbDoc]
2013-10-08 Created demo for solving pipeline multiplexing with DMA. This simple implementation uses the step incrementation in DMA Auto transfer split the sample stream in two. Afterwards it merges the two stre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
2013-10-08 Board routed 100%.
    [pcb_take2.PcbDoc, take1.PrjPcb]
2013-10-08 Slightly modified PCB tak2, adding group name and list of members
    [pcb_take2-1.PcbDoc]
2013-10-09 Updated take2-1, fixed mini jacks
    [pcb_take2-1.PcbDoc]
2013-10-09 Slight minijack footprint modification.
2013-10-09 Fixed various footprints and slightly increased spacing on the card
    [MICROSD.PcbLib, SR10S3V3_Footprint.PcbLib, pcb_take2-1.PcbDoc, take1.PrjPcb, uart_usb_bridge.SchDoc]
2013-10-09 Renamed minijacks
    [audio_interface.SchDoc, pcb_take2-1.PcbDoc]
2013-10-09 Test implementation of ADC -> MEM -> MEM -> MEM -> DAC, not working.
    [memmem.c]
2013-10-09 Added a stubversion of the FPGA Driver
2013-10-09 Added buttoncontroller
2013-10-09 Added 1.2V region to power plane.
    [pcb_take2-1.PcbDoc]
2013-10-10 EBI controller testbench and fixes
    [ebi_controller.vhd, internal_bus.vhd, tb_ebi_controller.vhd, toplevel.vhd]
2013-10-13 Working DMA triggered from TIMER0
2013-10-13 DMA triggered by TIMER with indirection.
2013-10-13 DMA trigger by multiple TIMERS (0 and 1)
2013-10-13 Change EBI bus width to 23 bits and update UCF with new pin names
2013-10-13 Fixed compile errors
    [arm_sheet.SchDoc, audio_interface.SchDoc, fpga_power.SchDoc, fpga_sheet.SchDoc, oscillation.SchDoc, overall.SchDoc, sram.SchDoc, uart_usb_bridge.SchDoc]
2013-10-13 Unified the naming of the three line control bus
    [arm_sheet.SchDoc, fpga_power.SchDoc, fpga_sheet.SchDoc, overall.SchDoc]
2013-10-13 Fixed some compile warnings
    [arm_sheet.SchDoc, fpga_flash_debug.SchDoc]
2013-10-13 Updated PCB layout
    Moved components that had overlapping pads.
    Moved slik text that overlapped with pads.
    Re-arranged opamp.
    [pcb_take2-1.PcbDoc]
2013-10-14 Improvements. Partially routed.
    [SR10S3V3_Footprint.PcbLib, audio_interface.SchDoc, fpga_flash_debug.SchDoc, overall.SchDoc, pcb_take2-1.PcbDoc, power_supply.SchDoc, uart_usb_bridge.SchDoc]
2013-10-14 Added partion lines to PCB overlay. Renamed a few units.
    [fpga_flash_debug.SchDoc, pcb_take2-1.PcbDoc, uart_usb_bridge.SchDoc, user_interface.SchDoc]
2013-10-14 Fixed short circut in power supply. Prerouted and locked all power lines
    [pcb_take2-1.PcbDoc, user_interface.SchDoc]
2013-10-14 Re-routed, fixed all short circuts
    [pcb_take2-1.PcbDoc]
2013-10-14 Project file updated
    [take1.PrjPcb]
2013-10-14 Exported gerber files
    [pcb_take2-1.PcbDoc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]
2013-10-15 Tried to add logo, but I have no idea how good it will be.
    [pcb_take2-1.PcbDoc, take1.PrjPcb]
2013-10-15 Improved logo.
    [pcb_take2-1.PcbDoc]
2013-10-15 finished setting up case statements
2013-10-15 Skordals flash added. Fuuu
    [XCF16PVOG48C.PcbLib, XCF16PVOG48C.SchLib, fpga_flash_debug.SchDoc, pcb_take2-1.PcbDoc, power_supply.SchDoc, take1.PrjPcb]
2013-10-15 Fully routed board in 6mins
    [pcb_take2-1.PcbDoc]
2013-10-16 Fixed flash footprint
    [XCF16PVOG48C.PcbLib, XCF16PVOG48C.SchLib, fpga_flash_debug.SchDoc, pcb_take2-1.PcbDoc]
2013-10-16 Added Working basic multiple DMA transfers
2013-10-16 I think we are done -- heh.
    [power_supply.SchDoc]
2013-10-16 Told ya.
    [fpga_flash_debug.SchDoc]
2013-10-16 Implemented Basic DMA transfer.
2013-10-16 Final gerber output and macaos PCB file
    [pcb_take2-1.gbl, pcb_take2-1.gbo, pcb_take2-1.gbp, pcb_take2-1.gbs, pcb_take2-1.gko, pcb_take2-1.gtl, pcb_take2-1.gto, pcb_take2-1.gtp]
2013-10-17 Finish UCF file according to PCB schematics
2013-10-17 Correct multiple drivers problem in program counter
2013-10-17 Add reset signal to PC in core
    [core.vhd]
2013-10-17 removed button-demo
2013-10-19 Working Split With Basic DMA
2013-10-19 ASCI art describing the ADC->FPGA->DAC flow.
2013-10-20 Wrote about layer stack and power supply in PCB report.
2013-10-21 Changed the sample clock frequency.
2013-10-22 Report: Added subsection structures in power supply chapter. Re-wrote some stuff for clarity.
2013-10-22 Prevent ISE from removing the EBI controller FSM
    [ebi_controller.vhd]
2013-10-22 Fix EBI controller addressing on the internal bus
    [ebi_controller.vhd, internal_bus.vhd]
2013-10-23 Bug fixes for register file
    [core_constants.vhd, register_file.vhd]
2013-10-23 Started a PCB test plan, and expanded the section about our PCB stack
2013-10-24 Initial commit of first pipeline stage
2013-10-26 Report: Read through additions to pcb section. Fixed typos,typos, refomulated some, added some stuff.
2013-10-26 Working Read on interrupt from DAC.
2013-10-29 Updated note about programming interfaces and power over USB
2013-10-29 Added note about reading the output from current sensors
2013-10-29 Report: Added PCB introduction
2013-10-29 Exported final schematic to PDF
2013-10-29 Updated file ending on schematics pdf
2013-10-29 Report: PCB, added schematics intro.
2013-10-30 Fixed driver for bitless
    [main.c]
2013-10-30 Added discussion part, made small edits in pcb files.
2013-10-31 Fix syntax errors, checking syntax before committing saves time
    [alu.vhd]
2013-11-01 Fixed the EBI controller - now follows the spec correctly (tested)
    [ebi_controller.vhd, tb_ebi_controller.vhd]
2013-11-03 fixed fpu more, updated core
    [core.vhd]
2013-11-03 Fixed missing libraries, syntax check done on ALU
    [core_constants.vhd]
2013-11-03 Fix sensitivity list for the monstermux
    [pipeline.vhd]
2013-11-04 Updated some ALU bugs
    [alu.vhd, core_constants.vhd]
2013-11-04 Removed the internal bus connections from ringbuffer + various fixes
    [pipeline.vhd]
2013-11-04 Totally messed up commit messages on this and the previous commit
    This one includes the ringbuffer fix, the previous one contains
    pipeline changes. This commit also hackfixes a clock issue we should
    probably discuss.
    [ringbuffer.vhd]
2013-11-04 Implemented most of the later stages.
2013-11-04 Fixed core. Depends on FWU and CU being fixed. :)
    [core.vhd, core_constants.vhd]
2013-11-04 Added ledscontroller
2013-11-04 Moved driver-files under controller
2013-11-04 fixed read of FPGA pipeline status
    [FPGAController.c]
2013-11-05 Update DMA config
2013-11-05 Just structured the structure.tex file (modeled after current chapters and their order). Also added a preliminary first revision of the FPGA chapter overview.
2013-11-05 Moved leds from controllers to modules
2013-11-05 Fix reset behaviour of the EBI controller
    [ebi_controller.vhd]
2013-11-05 Fix EBI/internal bus interactions in toplevel and pipeline
    [internal_bus.vhd, pipeline.vhd, toplevel.vhd]
2013-11-05 Moved content from driver to controller and fixed pins for buttons
    [main.c]
2013-11-05 Added ledcontroller to demo
2013-11-05 Updated forwarding unit, must fix for STB.
    [forwarding_unit.vhd]
2013-11-05 Deleted buttonsdriver
2013-11-05 Renamed buttons module
2013-11-05 Renamed leds module
2013-11-05 Added most of the logic to core. Started fixing control_unit.
    [control_unit.vhd, core.vhd, core_constants.vhd]
2013-11-05 Fixed syntax, control unit
    [control_unit.vhd, control_unit_constants.vhd]
2013-11-05 Fixed FWU and started implementing in core.
    [core.vhd, forwarding_unit.vhd]
2013-11-06 Core synthesizes! Also fixed forwarding unit.
    [core.vhd, forwarding_unit.vhd]
2013-11-06 Renamed back to ebidriver, fixed ebi_disable
    [main.c]
2013-11-07 Set to uart0, fixed name conventions
    [bl_uart.c, bl_uart.h, main.c]
2013-11-07 Renamed serial to uart, renamed buttons
2013-11-07 Moved ADC, DAC, DMA, PRS, MEM and SD code to modules
2013-11-07 Added Interrupt and util test
2013-11-07 Delted unused driver-files
2013-11-07 Deleted drivers/ebi
2013-11-07 Update sample conversion with tests
2013-11-10 Add binary radix to register file literals
    Also made the register array include index 0, to ensure
    correct behaviour when reg_1_address = b"11111", in which
    case the overflow when calculating the index for reg_1b_data
    will cause regs(0) to be accessed.
    [register_file.vhd]
2013-11-10 Implement reset functionality for the ringbuffer
    The step size in ring mode should now also be configurable
    [pipeline.vhd, ringbuffer.vhd]
2013-11-10 Upgrade the ringbuffer testbench and add switchmode tests
2013-11-10 Overwritten leds main demo
2013-11-10 Small changes to uart interface
2013-11-11 MCU dataflow: rewrote for flow, ask me if you don't agree. Increased size of Flow of samples-figure. Appeared too small to read.
2013-11-11 MCU dataflow: typos, flow, todos. Make sure you refer to the figures in the text when they have been added. PCB: added fixes.tex
2013-11-11 Added todo in FPGA intro. PCB fixes rewritten. Have to go through everything and remove WE-wording. The report should be objective.
2013-11-13 Solved an error caused by Flags.overflow having multiple drivers
2013-11-13 I derped, register file has been fixed again
    [register_file.vhd, tb_register_file.vhd]
2013-11-13 Fixed forwarding_unit and control unit
    [control_unit.vhd, core.vhd, forwarding_unit.vhd]
2013-11-13 Added Interrupt
2013-11-13 Fixed timing of reads in constant mem and reg file
    [constant_memory.vhd, register_file.vhd, tb_register_file.vhd]
2013-11-13 Moved sample clk to ctrl_bus3 as this is a GCLK pin
2013-11-13 ALU testing. float to fixed and back works
    [alu.vhd, tb_alu.vhd]
2013-11-13 fixed forward unit and control_unit
    [control_unit.vhd, core.vhd, forwarding_unit.vhd, forwarding_unit_ex.vhd]
2013-11-13 Written all 8 tests, haven't been able to attempt testing yet due to some wrong word lengths. Pushing to fix this quicker on another pc.
    [tb_core.vhd]
2013-11-13 Fixed what needed to be fixed in previous commit. Still lack writing the actual store test lines.
    [tb_core.vhd]
2013-11-13 Fixed some typos in last commit... copy/paste ftl...
    [tb_core.vhd]
2013-11-13 MAnaged to get the file to run in modelsim. Only the three first tests work correctly, seeing as they're the only ones whose input comes in. None of the tests 'outputs' have been checked, or seem to 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
    [tb_core.vhd]
2013-11-14 Fix enable support for the blink controller
    [blink_controller.vhd]
2013-11-14 A fix for ALU which most likely makes fp work
    [alu.vhd, tb_alu.vhd]
2013-11-14 fixed fpu more betterer
    [fpu.vhd]
2013-11-14 fixed control unit and disable core
    [control_unit.vhd, core.vhd]
2013-11-14 Set correct ringbuffer reset values
    [ringbuffer.vhd]
2013-11-14 Fix EBI communication with hacks and stuff, seems to work *<:)-<-<
    [ebi_controller.vhd, internal_bus.vhd, pipeline.vhd, tb_toplevel.vhd, toplevel.vhd]
2013-11-14 Revert "FINAL ALU testbench. ALU now works"
    This reverts commit 377923c48eb30502e7835e02fa91ec826777f395.
    [tb_alu.vhd]
2013-11-14 Revert "fp-mac now tested and it works"
    This reverts commit 048b9a2c4fe2b3447b52a021be809a75b14db3e7.
    [alu.vhd, core.vhd, fpu.vhd, tb_alu.vhd]
2013-11-14 Moved interrupt module
2013-11-14 Removed unused files and fixed constants.
    [bitless-cli.py, bl_sdi.c]
2013-11-14 Fix pipeline register record
    [internal_bus.vhd]
2013-11-14 Removed buttons and leds
2013-11-14 Prevent overflow in instruction memory address
    [instruction_memory.vhd]
2013-11-14 Fixed some errors in test load instructions
    [tb_core.vhd]
2013-11-14 Fixed branch, need to fix finalize
    [core.vhd, tb_processor_core_magnus.vhd]
2013-11-14 Revert "Updated ringbuffer, no warnings, not tested."
    This reverts commit 001a2424c939dabf7088bc7668a535559bd6db96.
    Does not synthesise and changes the interface to the other modules.
    [ringbuffer.vhd]
2013-11-15 Work on integrating the wavplayer and stored filter program
2013-11-15 Fixed the button driver
    [bl_buttons.c, bl_buttons.h, main.c]
2013-11-15 Fix instruction memory address calculations
    [instruction_memory.vhd]
2013-11-15 Fix toplevel testbench, stuff works *<8D-<-<
    One pipeline, input buffer + core + output buffer was tested on the FPGA
    and works.
    [tb_toplevel.vhd]
2013-11-15 Add one sample program.
2013-11-16 Revert "Revert "Updated ringbuffer, no warnings, not tested.""
    This reverts commit f862d106854f6a7ff2f5ef7daee803a5fe653bd6.
    [ringbuffer.vhd]
2013-11-16 Revert "Optimized adder."
    This reverts commit eb0c8455cf1bd2c9eac5a5f26e0056f35df7a044.
    [adder.vhd, alu.vhd, blink_controller.vhd, core.vhd, pipeline.vhd, tb_alu.vhd]
2013-11-16 reset update on falling_edge
    [core.vhd]
2013-11-16 Revert "updated tb_alu"
    This reverts commit 66f009468fc4fecf77c3893cf1d28e28803fea02.
    [carry_lookahead_adder.vhd, carry_lookahead_adder_4.vhd, lookahead_carry_unit.vhd, tb_alu.vhd]
2013-11-16 Fix indexing problems in instruction memory
    [instruction_memory.vhd]
2013-11-16 Fixed some small bugs, program now run on button click but must be reflashed to run more than once.
2013-11-16 fixed core ctrl reg
    [FPGAController.c]
2013-11-16 Added spi.c to make
2013-11-16 Fixed the command values
    [bl_sdi.c]
2013-11-16 Fixed last mem errors
    [FPGAController.c]
2013-11-17 Minor fixes in ebi demo programs, added fpga base address
    [FPGAController.h, bl_ebi.h, fpga.c, fpga2.c, main.c]
2013-11-17 Added schematics as appendix. PCB modifications.
2013-11-17 updated opcodes and fixed abnormal indentation
    [control_unit.vhd, control_unit_constants.vhd]
2013-11-18 Wrote a bit about the USB-UART interface
2013-11-18 Small rewrite of the mcu introduction for better flow of text.
2013-11-18 PCB: Components overhaul.
2013-11-18 PCB overhaul cont'd
2013-11-18 Added details of DMA
2013-11-18 Footprints table added. Needs finishing later.
2013-11-18 First revision of the PCB chapter by me finished up to and including the components subsection
2013-11-18 Moved PCB testing to methodology.
2013-11-18 Wrote a bit about power measurements.
2013-11-18 Moved: PCB fixes to results.
2013-11-18 Changed to Title Case everywhere. Removed some trailing whitespaces.
2013-11-18 PCB-results overhaul.
2013-11-18 PCB done. Do not touch. JK.
2013-11-19 Re-added pcb programming. Started on PCB ee design.
2013-11-19 Added image of voltage regulator hack.
2013-11-19 Added more images to PCB fix chapter.
2013-11-19 PCB hacks.
2013-11-19 Moved assembler appendix to FPGA implementation.
2013-11-19 Some improvements on improvements. Still missing some pcb-improvements
2013-11-20 I2C mention explained.
2013-11-20 PCB: finishing touches.
2013-11-20 Added PCB pictures
2013-11-20 Footprints table completed.
2013-11-20 Added pitfalls. Completed text on PCB improvements.
2013-11-20 Title Case.
2013-11-20 Title Case v2.
